HyFiVeUser/HyFiVe/01_Logger/01_Basic_Logger/04_Sensors/sensorIntegration.md

# Functionality of the Sensors
## Pyroscience Pico O2
- this sensor is equiped with a UART interface
- connect it to a UART-USB-Adapter
- you can send and recive informations according to the [Comunication Protocoll](https://www.pyroscience.com/en/products/all-meters/pico-o2-sub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)
- you can use the Pyro DeveloperTool to configurate and calibrate the device, see live values and execute measurements

## Atlas scientifig K0.1 | K1.0 | K10
- this sensor is delivered with the EZO-EC board for communication
- the EZO-EC board is equiped with a UART interface and an I2C interface
  - we are using the UART interface
- connect it to a UART-USB-Adapter
- you can send and recive informations according to [EZO ec datasheet](https://files.atlas-scientific.com/EZO-EC-complete-datasheet.pdf)

**NOTE: The result value may be 0 if the measured value is out of range.**

## BlueRobotics TSYS01
- this sensor is equiped with a I2C bus
- the sensor is the slave, so you need to connected it to an existing I2C Bus
- you can send and recive informations according to the [datasheet](https://www.te.com/commerce/DocumentDelivery/DDEController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)

## Keller Series 20

---

# Interfaces used for communication
## UART
- We are using the PmodUSBUART as Interface
- you can find it on [reichelt](https://www.reichelt.de/de/de/shop/produkt/pmod_usb-uart_usb-zu-uart-schnittstelle-243339)
- the manual is also available as [pdf at reichelt](https://cdn-reichelt.de/documents/datenblatt/B300/DIGILIENT_PMODUSBUART_ENG_TDS.pdf)
- there is no driver necessary when using Win10 or Win11
- after connecting to the PC check for the associated com port at the device monitor
- using a serial terminal (e.g. [Putty](https://putty.org/index.html) to establish a connection
- check the commands at the reference manual of the sensor (see above)
- The Pins of the Interface are the following:

|Pin|Signal|Description|
|---|---|---|
|1|RTS|Ready to Send|
|2|RXD|Receive|
|3|TXD|Transmit|
|4|CTS|Clear to Send|
|5|GND|Ground|
|6|SYS3V3|Power Supply (3.3V)|

## I2C
- We are using the [WCH341A Chip](https://wch-ic.com/products/CH341.html), provided on a [platine by berrybase](https://www.berrybase.de/usb-i2c-iic-spi-uart-ttl-isp-all-in-one-konverter-mit-ch341a-chipsatz)
- this interface has multiple capabilitys (I2C, UART, ...)
- You need to install a driver on windows, provided bei the manufactor [WCH](https://www.wch-ic.com)
  - for UART install the [serial driver](https://www.wch-ic.com/downloads/CH341SER_EXE.html) (the rest works as described above)
  - for I2C install the [parallel driver](https://www.wch-ic.com/downloads/CH341PAR_EXE.html)
- There is a tool (no installation needed) for communication dedicated to this Chipset, called [CH341A_tool](https://github.com/tomek-o/CH341A-tool)
- You can search for connected participans on I2C and read/write on the bus
- check the reference manual of the sensor for commands to be used (see above)
- The Pins are directly named on the board

---

# Commissioning and calibration
## Pyroscience Pico O2
- This sensor needs to be initalized with the values provided by the sensor cap
- We use the Pyro DeveloperTool (provided by PyroScience)
<br><br>
- attach the sensorcap to the pico
- connect the pico with your PC
  - you can use the provided USB-Cable
  - you can also use any other USB-to-UART interface

- start the pyro DeveloperTool
- klick on settings on the top left corner
- enter the code of the sensor-cap label
- select if you want to use fixed enviromental values or measured ones
  - in this project we use fixed values, because this will be set during the sensorhandling process
  - set the ambientpreasure to 1013 mBar
  - set the salinity to 0 PSU
  - set the Temperature to 20 °C
<br><br>**TODO: images**<br><br>
- The sensor is now able to measure and you should get first rough values in the diagram
<br><br>**TODO: images**<br><br>
- there are diferent ways to execute a **Calibration**:
    - Calibrate in ambient air
    - Calibrate in water
      - as a single point calibration
      - as a two point calibration
<br><br>
- As we want to use the sensor in water and both (0% and 100% saturation) are in our interest we recommend to perform a two point calibration in Water
- for 0% oxygen you can use a solution of natriumdisulfit in water
- for 100% oxygen you can use water wich was enriched with air
  - you can use a bubbler
  - you can just it from one tumbler to another with plenty of space between them (so that the air is mixed in)
<br><br>
- The calibration is similar in both points
- put the sensor in the correct fluid
- wait until you get a stable value (check at the live diagram)
<br><br>**TODO: images**<br><br>
- Start the calibration process by clicking on "Calibration"
- choose wich point you want to calibrate
  - 0%
    - set to **TODO: check and doc correct settings**
  - 100%
    - set to **TODO: check and doc correct settings**
- This will take a few seconds
- afterwards the value is adjusted and you should have current values around your calibrationpoint
<br><br>**TODO: images**<br><br>
- after calibration you have to save the values to the flash memory
<br><br>**TODO: images**<br><br>

## Atlas scientifig K0.1 | K1.0 | K10
- the calibration is dependnt of the board and the sensor
  - you need to change the bundle of board and sensor for each calibration, instead of just switch the sensor
- connect the sensor with the corresponding board to the UART interface
- start a serial terminal and connect to the sensor
- you can read the current value with the command "*C,1*" (**C**ontinious read every **1** second)
- if the sensor was already calibrated (response to "*Cal,?*" is "*Cal,1*" or "*Cal,2*"), but has bad values you may like to calibrate it again
  - Therefore you should clear current calibration first with the command "*Cal,clear*"
  - response should be "*\*OK*"
  - Afterwards continue with the normal calibration process
<br><br>**TODO: images**<br><br>
- For calibration use two different calibration liquids
- you need to execute the whole calibration routine at once:
  - start with a dry sensor
  - enable reading, if not already enabled: "*C,1*"
  - wait for a stable value
  - send command "*Cal,dry*"
  - response should be "*\*OK*"
  - insert sensor in the lower calibration liquid
  - wait for a stable value
  - send command "*Cal,low,[value]*", where *[value]* is replaced by the conductivity of your probe in µS/cm
    - keep in mind to enter the correct value depending on the current temperature of your liquid. There should be temperature tables provided by the liquid manufactor, as the conductivity is highly influenced by the temperature
  - response should be "*\*OK*"
  - remove the sensor from the first calibration liquid, clean and dry it
  - insert sensor in the higher calibration liquid
  - wait for a stable value
  - send command "*Cal,high,[value]*", where *[value]* is replaced by the conductivity of your probe in µS/cm
    - keep in mind to enter the correct value depending on the current temperature of your liquid. There should be temperature tables provided by the liquid manufactor, as the conductivity is highly influenced by the temperature
  - response should be "*\*OK*"
  - the calibration is finished now
  - disable reading: "*C,0*"
  - response should be "*\*OK*"
  - you can check the calibration with the command "*Cal,?*", the response should be "*?Cal,2*" and "*\*OK*"

## BlueRobotics TSYS01
- Connect the Sensor to an I2C bus
- the adress should be 0x77
- to read the calibration coefficients you have to send the following commands and read the response (2bytes)
- the response (2bytes) is the result, represented as a hexadezimal value

|target|command|example response|decimal value|
|---|---|---|---|
|Coefficient k0|0xAA|0x8545|34117|
|Coefficient k1|0xA8|0x5865|22629|
|Coefficient k2|0xA6|0x3E7C|15996|
|Coefficient k3|0xA4|0x1CAA|7338|
|Coefficient k4|0xA2|0x1652|5714|

<br><br>**TODO: images**<br><br>

- for the hyfive-logger this values musst be transfered to the calibration settings of the sensor

## Keller Series 20
