HyFiVeUser/HyFiVe/01_Logger/02_Modular_Logger/02_Mechanics/01_electronic_mounting/logger_mounting_battery_base_V02.png

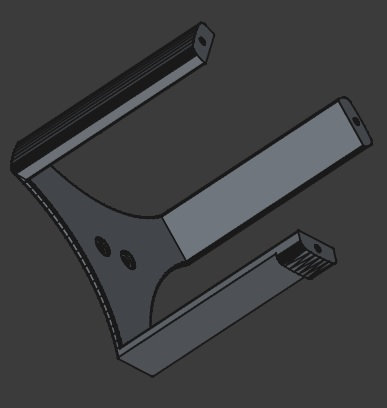
01_Logger/02_Modular_Logger/02_Mechanics/01_electronic_mounting/logger_mounting_battery_base_V02.png
