HyFiVeUser/HyFiVe/01_Logger/02_Modular_Logger/02_Mechanics/01_pressure_housing/02_cylinder/Logger_cylinder.png

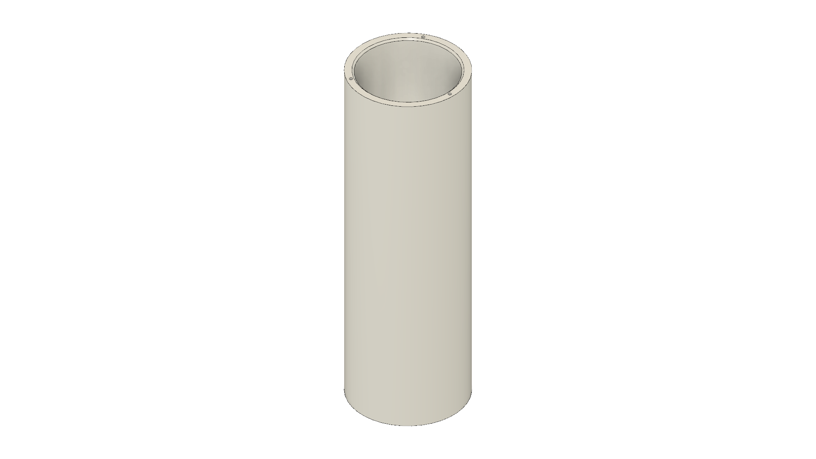
01_Logger/02_Modular_Logger/02_Mechanics/01_pressure_housing/02_cylinder/Logger_cylinder.png
