HyFiVeUser/HyFiVe/01_Logger/02_Modular_Logger/02_Mechanics/01_pressure_housing/03_endcaps/End_cap_drilling_charging.png

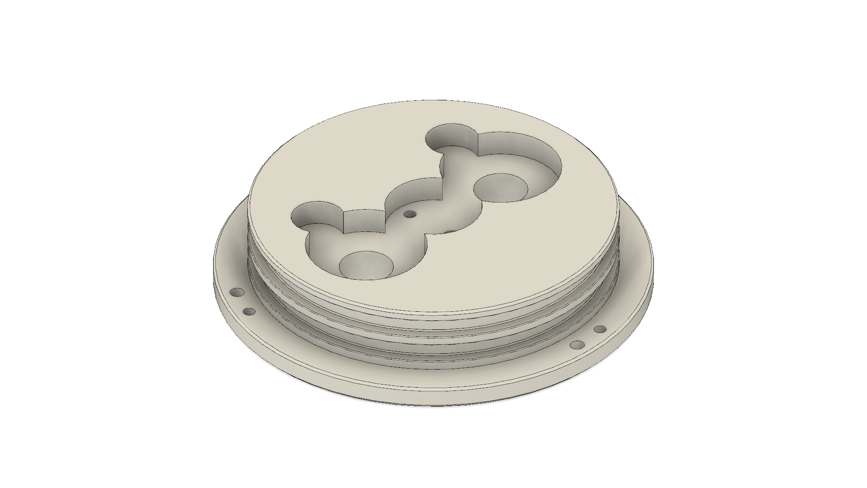
01_Logger/02_Modular_Logger/02_Mechanics/01_pressure_housing/03_endcaps/End_cap_drilling_charging.png
