HyFiVeUser/HyFiVe/01_Logger/02_Modular_Logger/02_Mechanics/01_pressure_housing/04_penetrators/penetrator_charging_V02.png

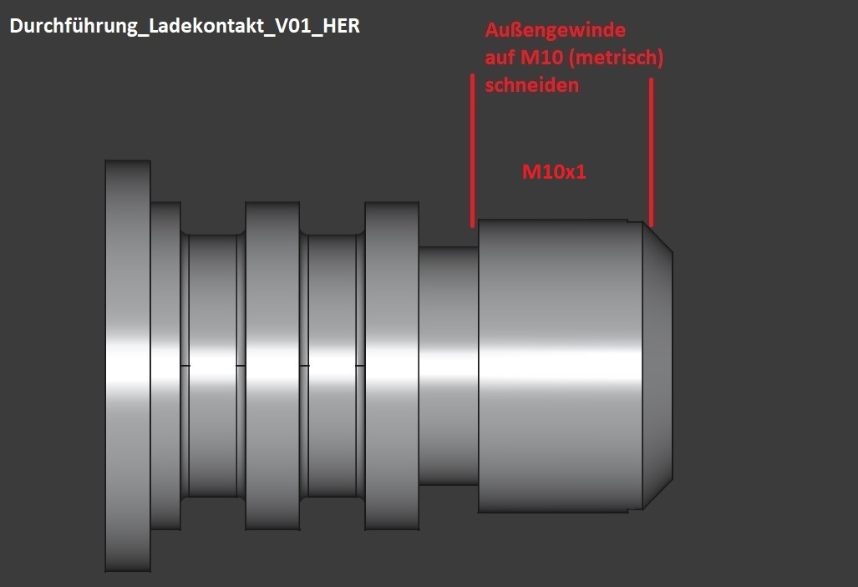
01_Logger/02_Modular_Logger/02_Mechanics/01_pressure_housing/04_penetrators/penetrator_charging_V02.png
