HyFiVeUser/HyFiVe/01_Logger/02_Modular_Logger/02_Mechanics/01_pressure_housing/04_penetrators/penetrator_sensor_Atlas_K1_0.png

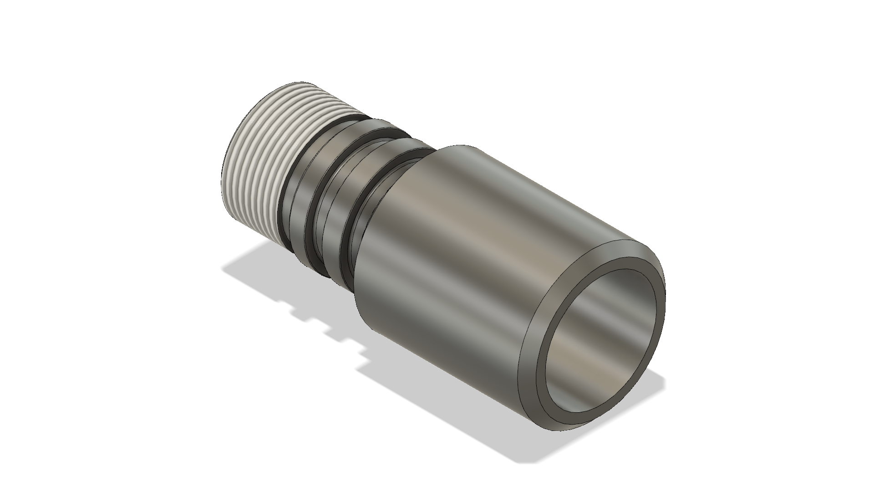
01_Logger/02_Modular_Logger/02_Mechanics/01_pressure_housing/04_penetrators/penetrator_sensor_Atlas_K1_0.png
