HyFiVeUser/HyFiVe/01_Logger/02_Modular_Logger/02_Mechanics/02_Handle_Rope/Cage_ring_metal v4.png

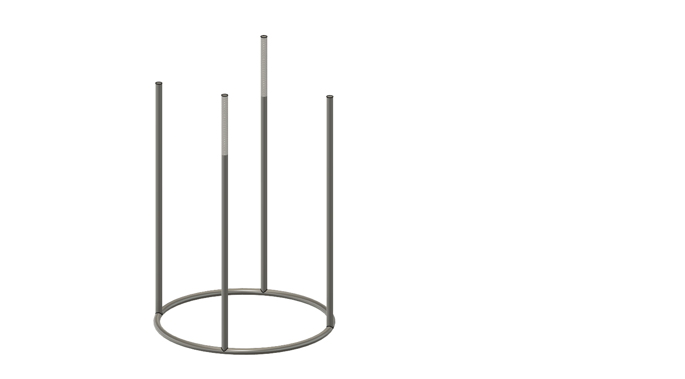
01_Logger/02_Modular_Logger/02_Mechanics/02_Handle_Rope/Cage_ring_metal v4.png
