HyFiVeUser/HyFiVe/02_Deckbox/02_Software/NodeRED/NodeRED_flow_02_MainFlows.PNG

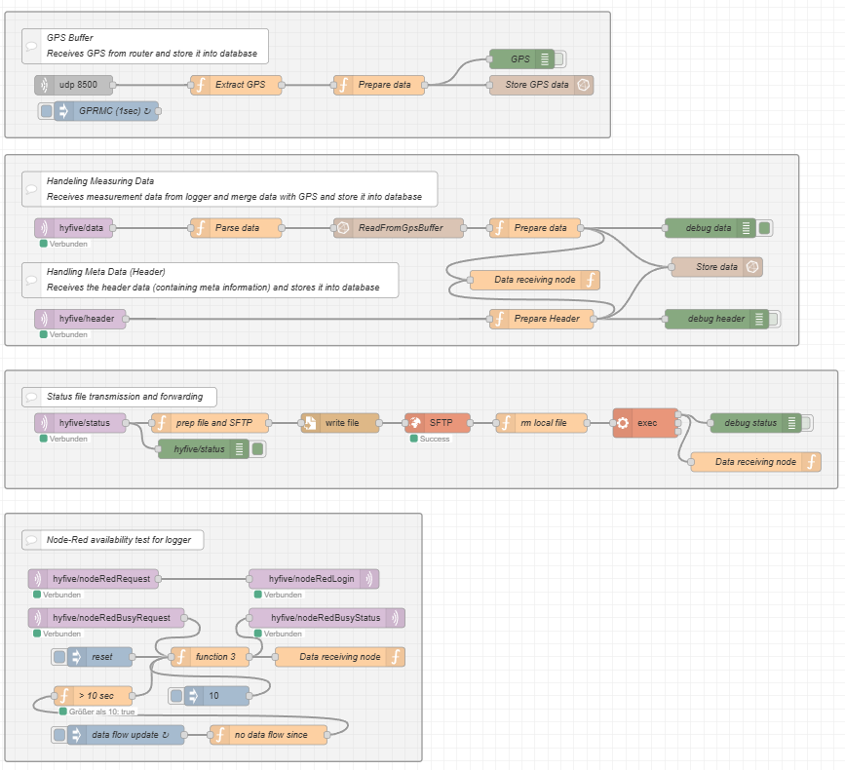
02_Deckbox/02_Software/NodeRED/NodeRED_flow_02_MainFlows.PNG
