HyFiVeUser/HyFiVe/02_Deckbox/02_Software/NodeRED/NodeRED_flow_03_netcdf.PNG

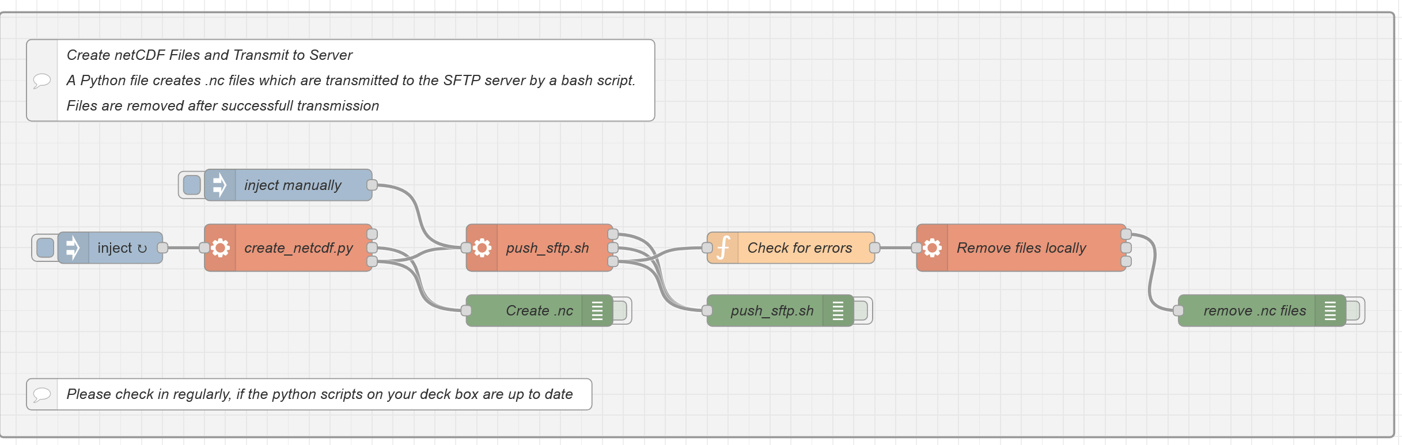
02_Deckbox/02_Software/NodeRED/NodeRED_flow_03_netcdf.PNG
