HyFiVeUser/HyFiVe/02_Deckbox/02_Software/NodeRED/NodeRED_flow_04_Logger log data.PNG

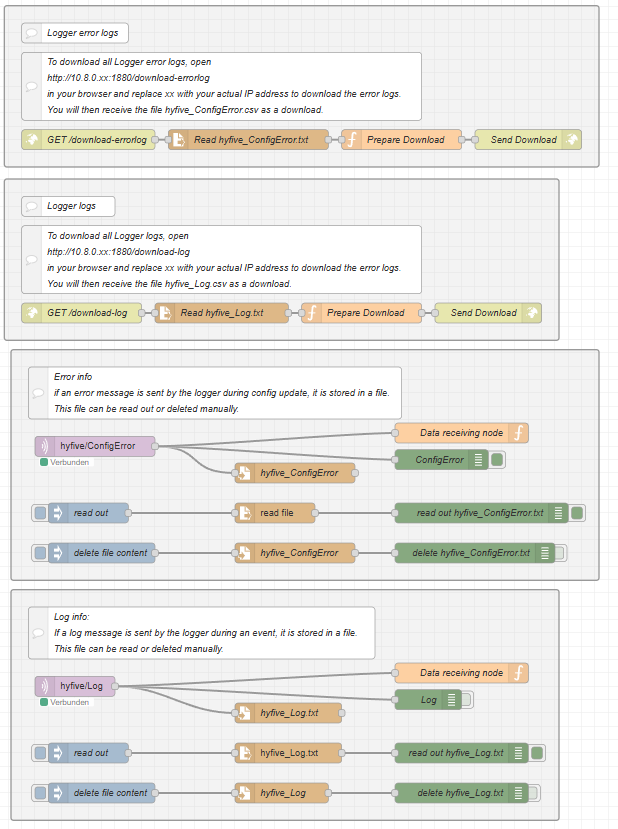
02_Deckbox/02_Software/NodeRED/NodeRED_flow_04_Logger log data.PNG
