HyFiVeUser/HyFiVe/02_Deckbox/02_Software/NodeRED/NodeRED_flow_05_updateConfig.PNG

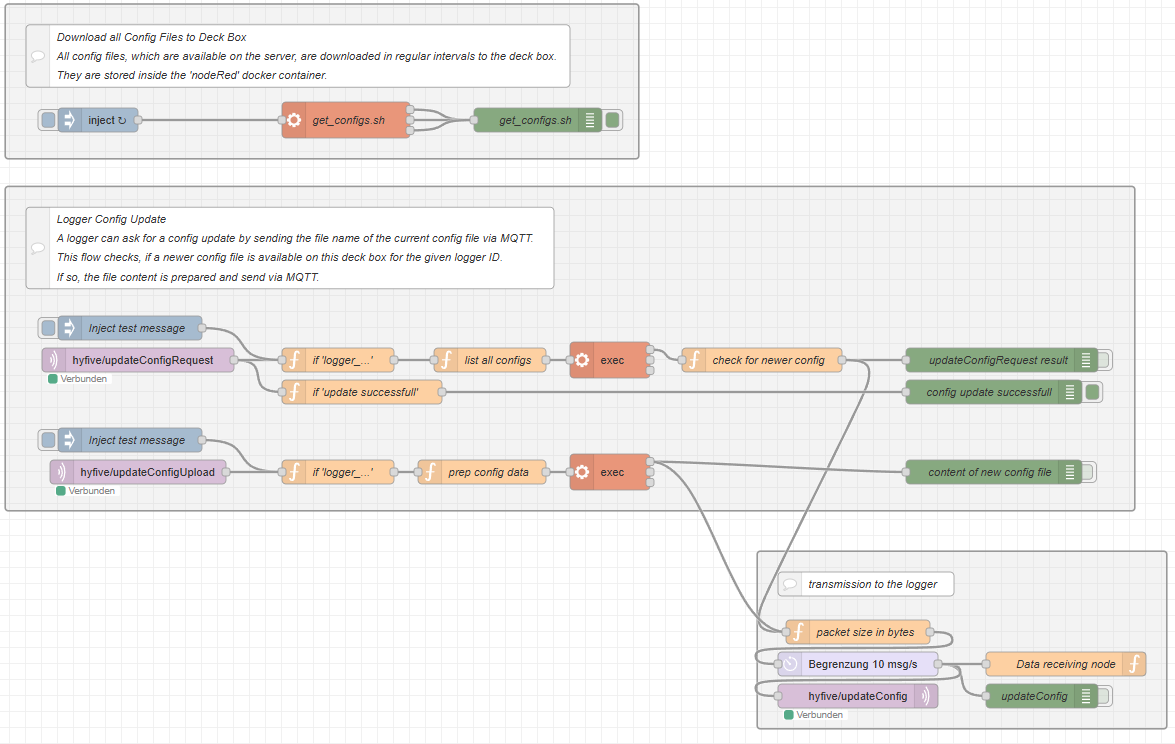
02_Deckbox/02_Software/NodeRED/NodeRED_flow_05_updateConfig.PNG
