HyFiVeUser/HyFiVe/02_Deckbox/02_Software/NodeRED/NodeRED_flow_06_firmware update OTA.png

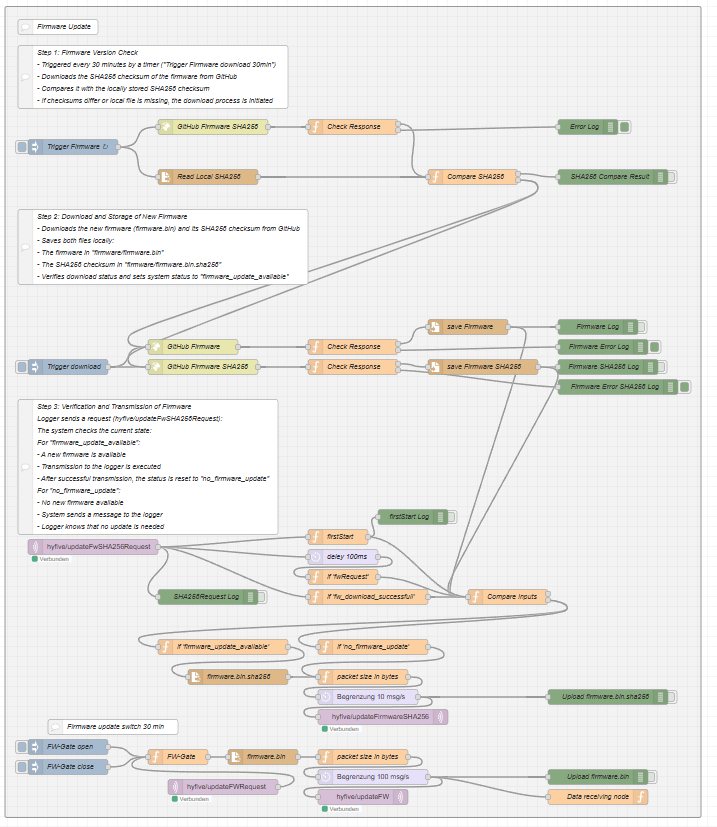
02_Deckbox/02_Software/NodeRED/NodeRED_flow_06_firmware update OTA.png
