HyFiVeUser/HyFiVe/01_Logger/01_Basic_Logger/02_Mechanics/BOM.xlsx

# | Amount | Name
 |  | Pressure cylinder
1 | 1 | Cylinder, POM, D 76/90, L 275, according to drawing
2 | 1 | End cap for sensors, according to drawing
3 | 1 | End cap, blank
4 | 6 | Screws M3 x 14, hexagonal, stainless A4
5 | 4 | O-ring 70 x 3, NBR70
6 | 1 | O-ring lube, e.g. Molycote 44 Medium
 |  | Internal mounting
7 | 1 | Mounting for electronic components, 3D printed
8 | 1 | Mounting for battery pack, 3D printed
9 | 3 | Tapping screw, M2.9 x 9.5, for attaching main PCB
10 | 1 | Screws M6 x 14, hexagonal
 |  | Sensors and accessories
11 | 1 | Temperature: BlueRobotics Celsius Fast Responde, incl. O-ring and nut
12 | 1 | Pressure: Keller 20D, 50bar, incl. adapter PCB
13 | 1 | Oxygen: Pyroscience picoO2sub incl. Oxycap-sub, O-ring and nut
14 | 1 | Conductivity: Atlas Scientific K1.0 incl. adapter board
15 | 1 | Bushing for conductivity sensor, incl. distance sleeve for potting
16 | 1 | Nut M18x1 ('Sechskant-Gegenmutter') GM 181 Schlüsselweite <= 22mm
17 | 2 | O-ring, 15.5 x 2, NBR70
18 | 1 | Pressure valve, BlueRobotics PRV-R1, incl. O-rings and nut
19 | 1 | Vacuum pump, BlueRobotics Vacuum-Pump-R1, incl. adapter for PRV
