HyFiVeUser/HyFiVe/01_Logger/02_Modular_Logger/02_Mechanics/01_electronic_mounting/logger_mounting_battery_base_V02.step

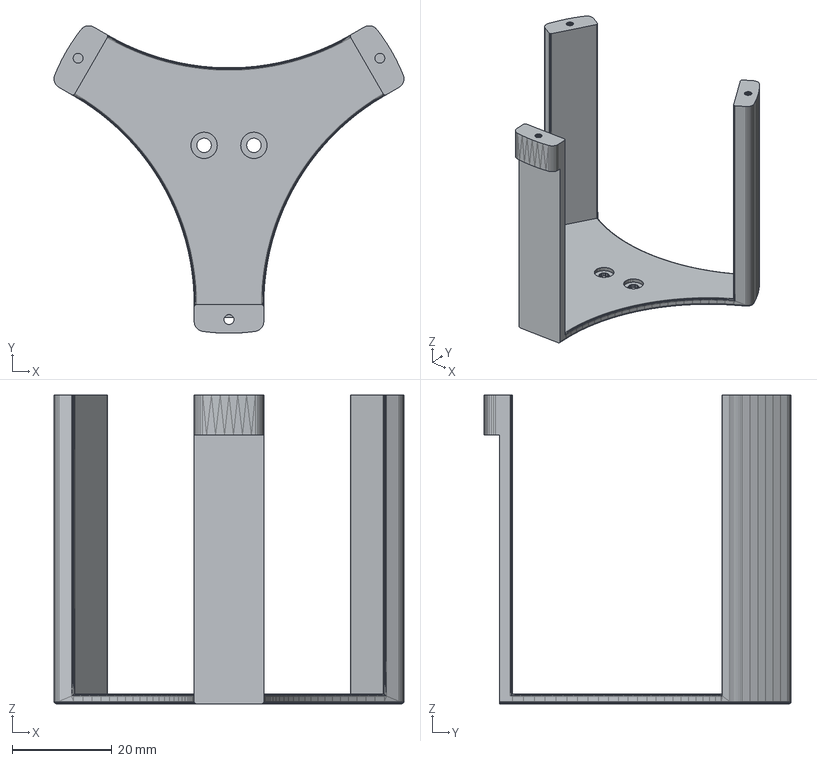
[picture p15: CAD file, 2025-11-10]
01_Logger/02_Modular_Logger/02_Mechanics/01_electronic_mounting/logger_mounting_battery_base_V02.step
70.3 x 61.8 x 62.0 mm
