HyFiVeUser/HyFiVe/01_Logger/02_Modular_Logger/02_Mechanics/01_pressure_housing/02_cylinder/Logger_cylinder.step

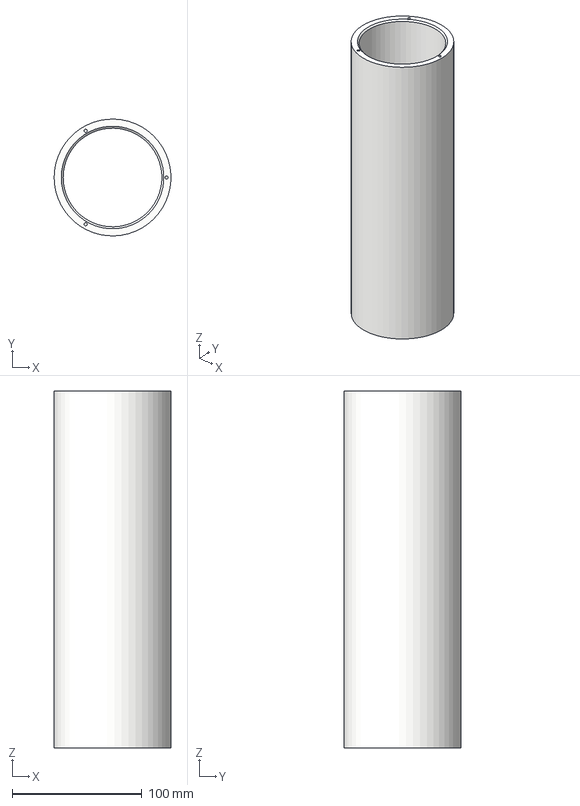
[picture p16: CAD file, 2025-11-10]
01_Logger/02_Modular_Logger/02_Mechanics/01_pressure_housing/02_cylinder/Logger_cylinder.step
89.9 x 90.0 x 275.0 mm
