HyFiVeUser/HyFiVe/01_Logger/02_Modular_Logger/02_Mechanics/01_pressure_housing/03_endcaps/end_cap_drillings_sensors_P6_V01.step

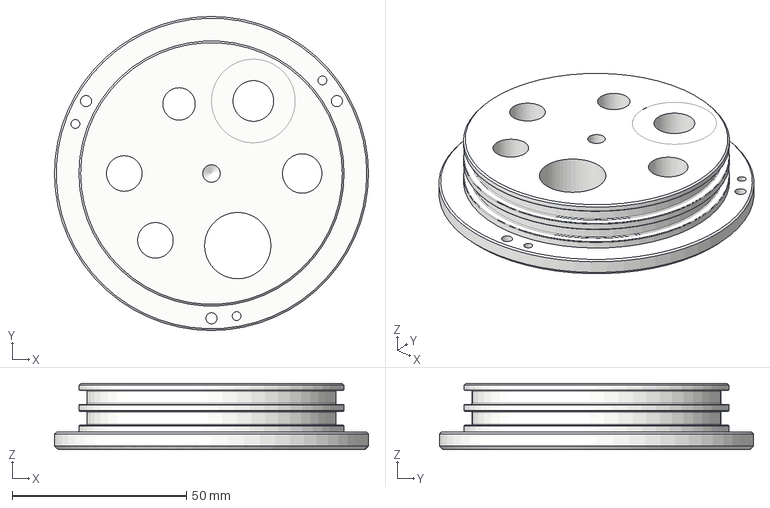
[picture p17: CAD file, 2025-11-10]
01_Logger/02_Modular_Logger/02_Mechanics/01_pressure_housing/03_endcaps/end_cap_drillings_sensors_P6_V01.step
90.0 x 90.0 x 19.0 mm
