HyFiVeUser/HyFiVe/01_Logger/02_Modular_Logger/02_Mechanics/01_pressure_housing/04_penetrators/penetrator_charging_V02.step

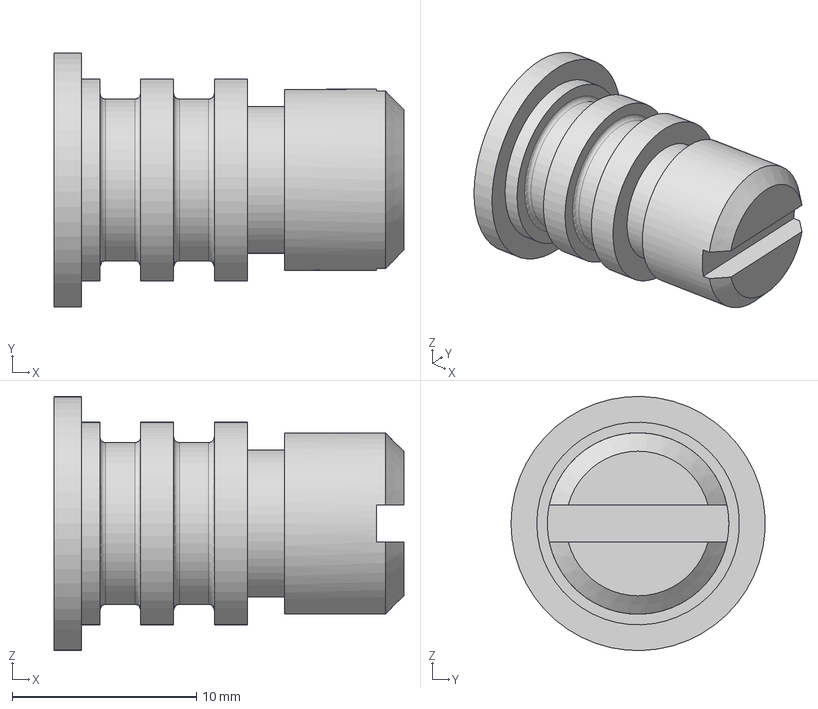
[picture p18: CAD file, 2025-11-10]
01_Logger/02_Modular_Logger/02_Mechanics/01_pressure_housing/04_penetrators/penetrator_charging_V02.step
19.0 x 13.8 x 13.8 mm
