HyFiVeUser/HyFiVe/01_Logger/02_Modular_Logger/02_Mechanics/02_Handle_Rope/3d_Print_Fixation_Ring_M5_realDim.step

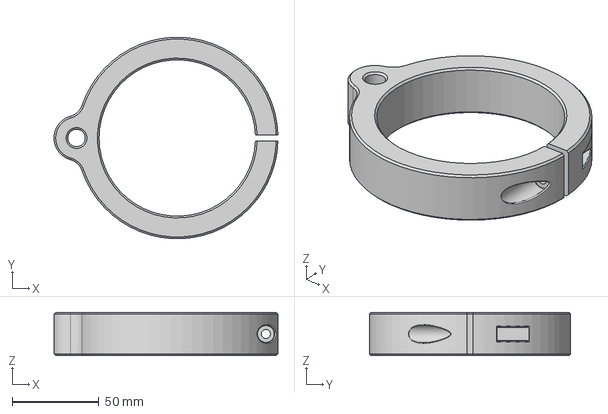
[picture p19: CAD file, 2026-03-27]
01_Logger/02_Modular_Logger/02_Mechanics/02_Handle_Rope/3d_Print_Fixation_Ring_M5_realDim.step
129.0 x 115.9 x 25.0 mm
