HyFiVeUser/HyFiVe/01_Logger/02_Modular_Logger/02_Mechanics/01_pressure_housing/04_penetrators/penetrator_sensor_Atlas_K1_0.step

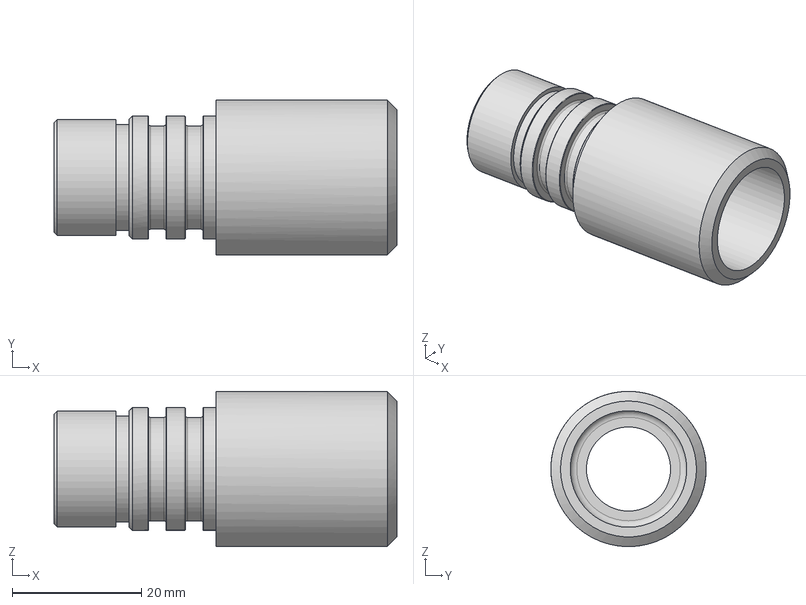
[picture p20: CAD file, 2025-11-10]
01_Logger/02_Modular_Logger/02_Mechanics/01_pressure_housing/04_penetrators/penetrator_sensor_Atlas_K1_0.step
53.0 x 24.0 x 24.0 mm
