HyFiVeUser/HyFiVe/01_Logger/02_Modular_Logger/02_Mechanics/01_pressure_housing/03_endcaps/End_cap_drilling_charging.step

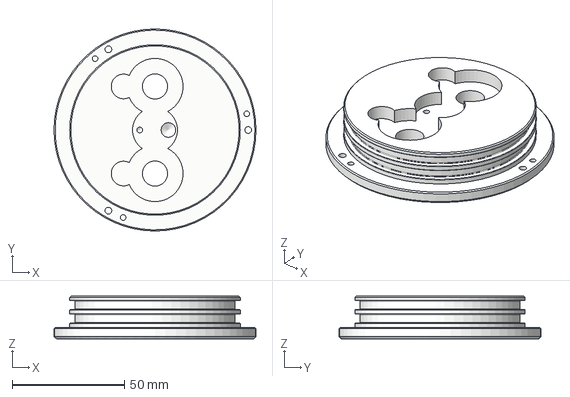
[picture p22: CAD file, 2025-11-10]
01_Logger/02_Modular_Logger/02_Mechanics/01_pressure_housing/03_endcaps/End_cap_drilling_charging.step
90.0 x 90.0 x 19.0 mm
