HyFiVeUser/HyFiVe/01_Logger/02_Modular_Logger/02_Mechanics/02_Handle_Rope/Cage_ring_metal.step

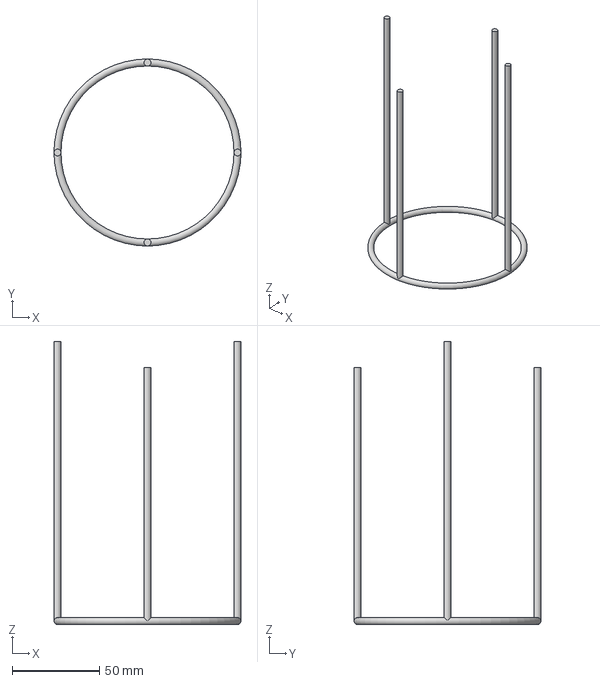
[picture p23: CAD file, 2026-03-27]
01_Logger/02_Modular_Logger/02_Mechanics/02_Handle_Rope/Cage_ring_metal.step
107.0 x 107.0 x 162.0 mm
