HyFiVeUser/HyFiVe/(list of files, cad)

Other CAD files:
01_Logger/02_Modular_Logger/02_Mechanics/01_pressure_housing/03_endcaps/end_cap_drillings_sensors_P5_V01.step
01_Logger/02_Modular_Logger/02_Mechanics/01_pressure_housing/02_cylinder/Logger_cylinder.f3d
01_Logger/02_Modular_Logger/02_Mechanics/01_pressure_housing/03_endcaps/End_cap_drilling_charging.f3d
01_Logger/02_Modular_Logger/02_Mechanics/01_pressure_housing/03_endcaps/end_cap_drillings_sensors.f3d
01_Logger/02_Modular_Logger/02_Mechanics/01_pressure_housing/04_penetrators/penetrator_sensor_Atlas_K1_0.f3d
01_Logger/02_Modular_Logger/02_Mechanics/02_Handle_Rope/3d_Print_Cage_Ring_M5_realDim.f3d
01_Logger/02_Modular_Logger/02_Mechanics/02_Handle_Rope/3d_Print_Fixation_Ring_M5_realDim.f3d
01_Logger/02_Modular_Logger/02_Mechanics/02_Handle_Rope/Cage_ring_metal.f3d
01_Logger/02_Modular_Logger/02_Mechanics/02_Handle_Rope/Handle_Rope_Assembly.f3z
