HyFiVeUser/HyFiVe/01_Logger/02_Modular_Logger/02_Mechanics/02_Handle_Rope/3d_Print_Cage_Ring_M5_realDim v3.png

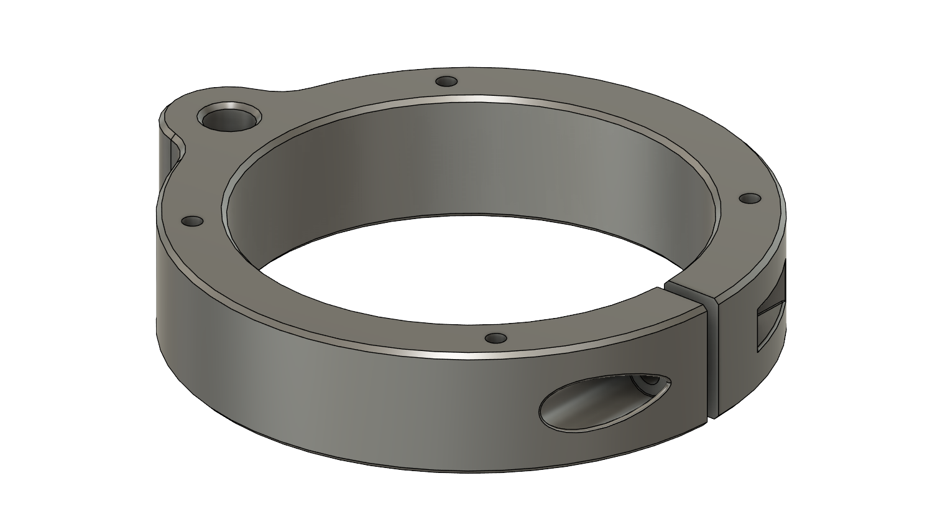
01_Logger/02_Modular_Logger/02_Mechanics/02_Handle_Rope/3d_Print_Cage_Ring_M5_realDim v3.png
