HyFiVeUser/HyFiVe/01_Logger/02_Modular_Logger/02_Mechanics/02_Handle_Rope/3d_Print_Fixation_Ring_M5_realDim v2.png

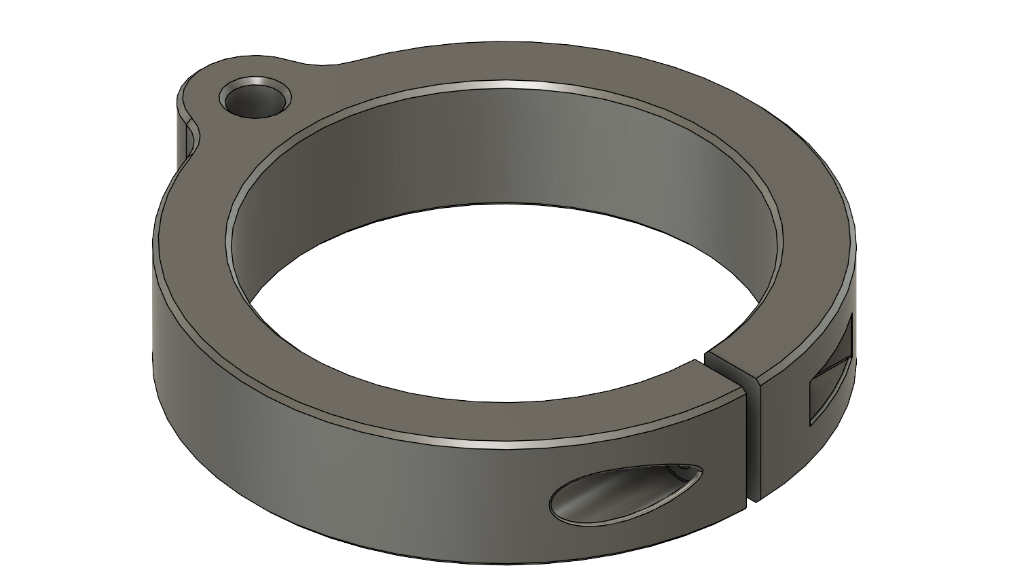
01_Logger/02_Modular_Logger/02_Mechanics/02_Handle_Rope/3d_Print_Fixation_Ring_M5_realDim v2.png
