HyFiVeUser/HyFiVe/02_Deckbox/02_Software/NodeRED/NodeRED_flow_07_TestFunctionality - Kopie.PNG

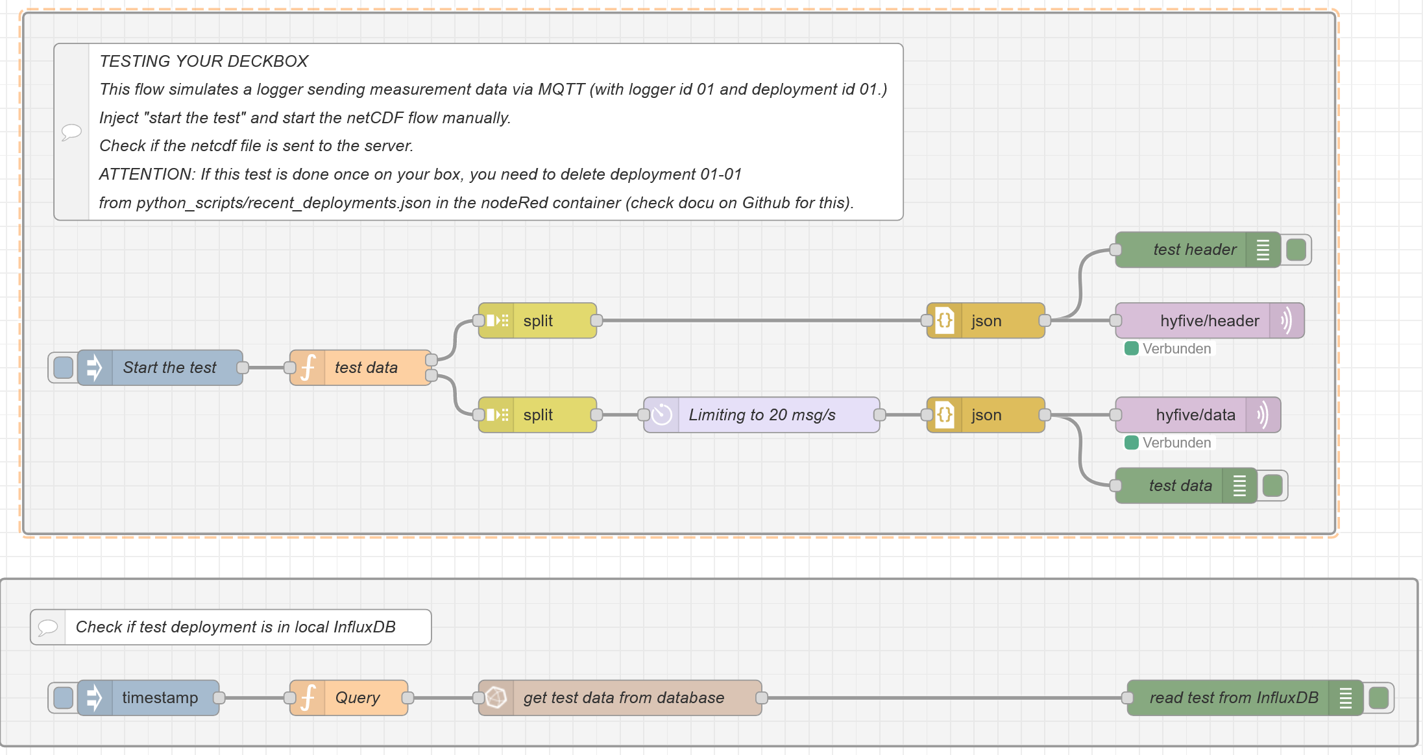
02_Deckbox/02_Software/NodeRED/NodeRED_flow_07_TestFunctionality - Kopie.PNG
