HyFiVeUser/HyFiVe/02_Deckbox/02_Software/NodeRED/NodeRED_flow_01_ChangeLog.PNG

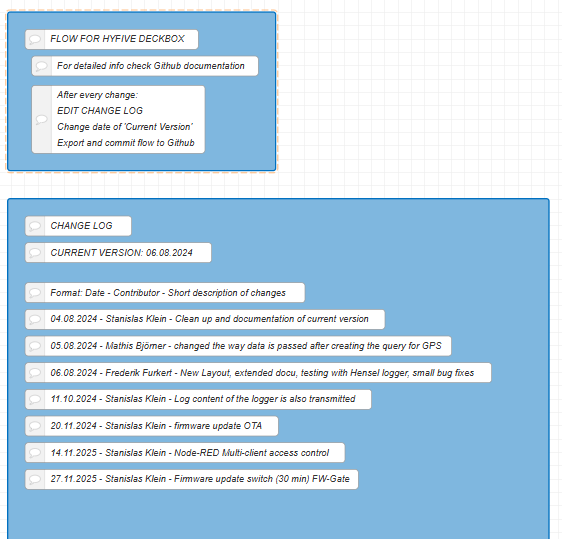
02_Deckbox/02_Software/NodeRED/NodeRED_flow_01_ChangeLog.PNG
