HyFiVeUser/HyFiVe/(threads)

Thread 4 (2025-09-16):

Logger stops charging before full charge

sw-of, 2025-09-16:
# Problem Description:
## Short Version:
The logger stops charging after increasing the SOC by 60-65%.

## Long Version:
When starting charging between a remaining SOC of 0% to 39%, the logger will stop charging before it reaches a full charge. In this case, the LED still blinks as if the logger is charging, but the SOC does not increase (checked in the status files). This will not change even if the logger remains plugged in for several hours.
To fully charge the logger, the charger must be unplugged and plugged in again. There is no waiting time required between unplugging and plugging in the logger.

## Workaround:
Restart charging (unplug and plug in the charger)

## Proposed Solution:
TBD - seems to be a BMS issue

Thread 5 (2025-09-17):

Unit of oxygen saturation should be ml/l in export data

sw-of, 2025-09-17:
# Problem description:
## short version:
In the data export as unit for the oxygen saturation should ml/l be used.

## long version:
the oxygen saturation is usually used to be ml/l instead of mbar (partial pressure). This could be also additional to the current values.

## workaround:
convert the values at your own ;)

## Proposed solution:
add a conversion to the sql-script or create a automatism in a excel sheet

Thread 6 (2025-09-17):

Structure of config-json is not good for human reading

sw-of, 2025-09-17:
# Problem description:
## Short version:
The sensor type is located near the end of the sensor field when reading the config JSON.

## Long version:
The config file contains several other values, including calibration factors, making it difficult to identify all installed sensor types. It would be easier to read if the sensor type were the first value within the sensor structure in the JSON file.

## Workaround:
None

## Proposed solution:
Reorganize the creation of the config JSON file to prioritize the sensor type.

Thread 8 (2025-09-17):

Broken battery holder/battery holder to small

sw-of, 2025-09-17:
# Problem description:
## Short version:
The battery holder is too short for the used battery pack.

## Long version:
In the following picture, you can see that there is a gap between the body and the lid of the battery holder. Additionally, the lid is slightly deformed. As a result, the lid has broken several times.
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

## Workaround:
Do not tighten the screw too much. Using a longer screw could be a additional improvment.

## Proposed solution:
Redesign the lid. The plate should be slightly thicker as well. Change the thickness of the plate to 2 mm and the length of the rod to 8 mm.

Thread 9 (2025-09-19):

Integration into O2A

Maysen42, 2025-09-19:
# Integration into O2A
O2A is a datapipeline framework developed by the Alfred Wegner Institute in Bremerhaven (AWI).
This framework would possibly allow a near realtime data distribution for HyFiVe plus automatic analysis of data, including malfunctioning sensor detection and overview over devices in use.

This might also be an option for a new visualisation interface, but that needs to be further investigated

Thread 12 (2025-10-01):

create_netcdf.py-script doesn't handle deployments as list instead of dataframe

Maysen42, 2025-10-01:
# Problem description:
## Short version:
In some cases create_netcdf.py needs to handle a list of dataframes instead of just a dataframe. Currently this isn't done right.

## Long version:
If the configurations of deployments, which shall be read from the influxDB, vary for example because there is a new sensor or one less then before, influx will hand this data as a list of dataframes, rather then just sending it in one dataframe, as would be the normal case.

## Workaround:
A current workaround could be to minimize the period in which to look for data in influxDB. As long as all the data from this period is homogenous, then the script will work fine.

## Proposed solution:
There should be an adaption in the main function where the influx-client calls for the data to check if the returned data is a list and should then be handled apropriately, one after the other.
The Parameters-part of the script should also be able to handle different parameter configurations which exist as lists.

Maysen42, 2025-10-01:
pushed some changes to the according branch. Commit needs to be tested and approved.
