HyFiVeUser/HyFiVe/01_Logger/02_Modular_Logger/02_Mechanics/01_pressure_housing/03_endcaps/production_drawing_end_caps_blank.pdf

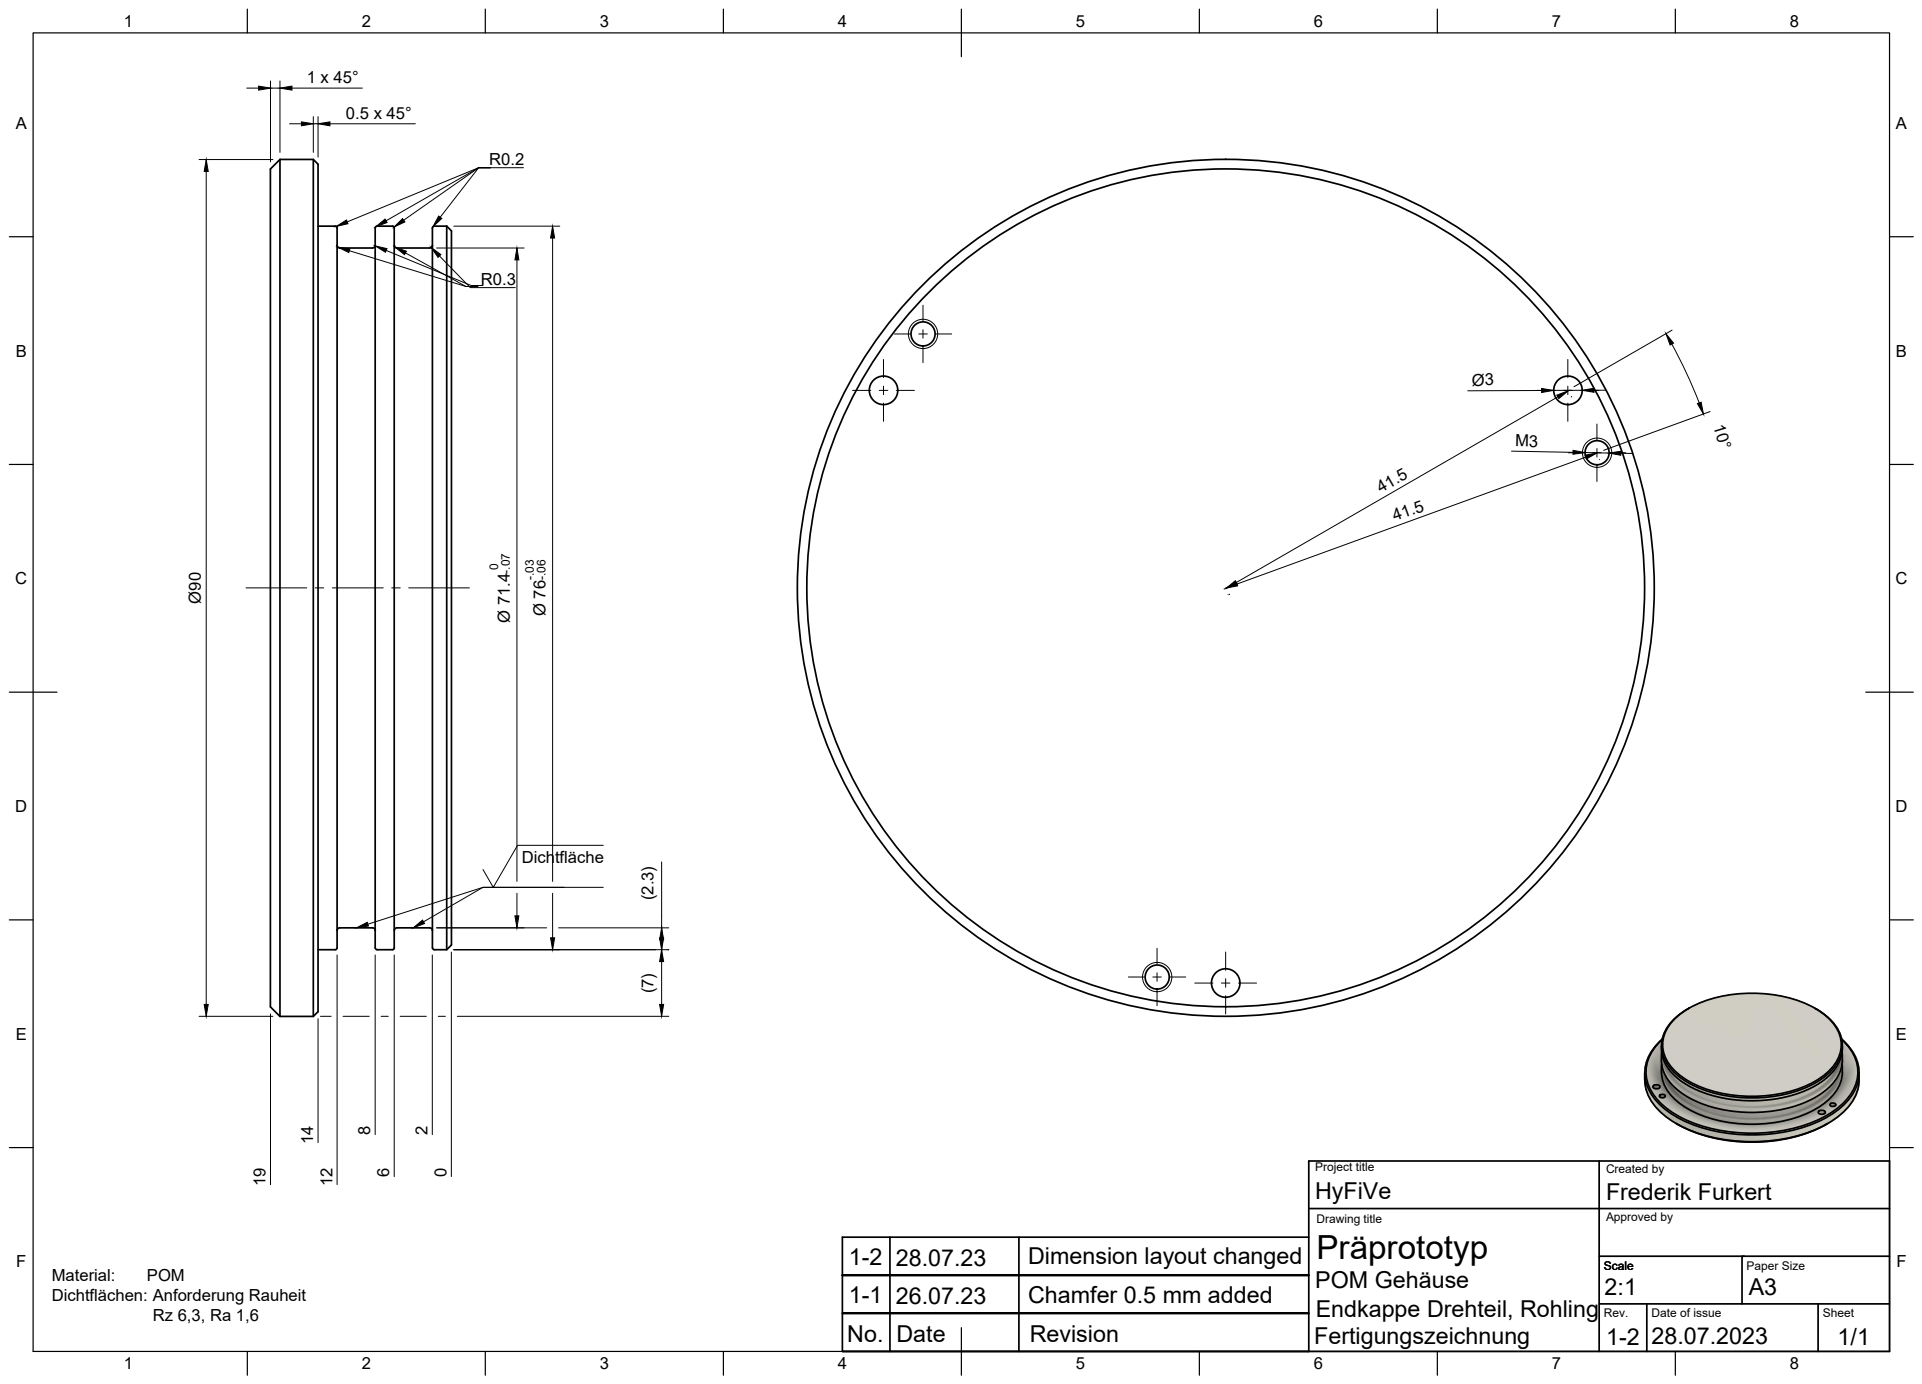
[picture p28: page 1]
Rev.; Date of issue; Sheet

Project title HyFiVe | Created by Frederik Furkert

Drawing title
Präprototyp
POM Gehäuse
Endkappe Drehteil, Rohling
Fertigungszeichnung

Approved by

1-2 | 28.07.23 | Dimension layout changed
1-1 | 26.07.23 | Chamfer 0.5 mm added

Dichtflächen: Anforderung Rauheit

Scale 2:1 | Paper Size A3
