HyFiVeUser/HyFiVe/01_Logger/02_Modular_Logger/02_Mechanics/01_pressure_housing/02_cylinder/production_drawing_cylinder.pdf

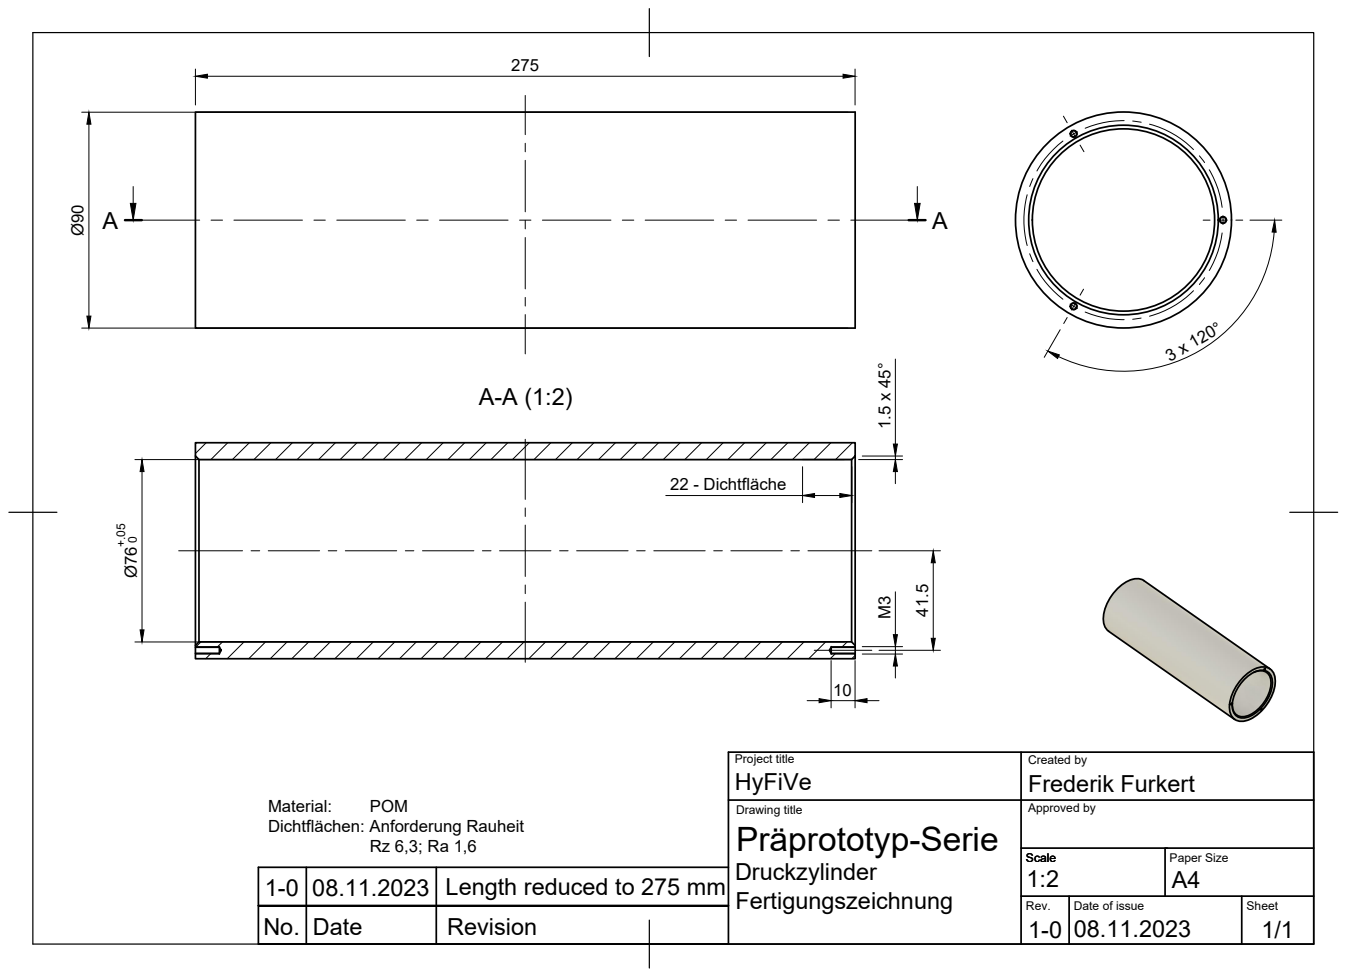
[picture p29: page 1]
Length reduced to 275 mm; 22 - Dichtfläche

Project title HyFiVe | Created by Frederik Furkert

Dichtflächen: Anforderung Rauheit

Drawing title Präprototyp-Serie Druckzylinder Fertigungszeichnung | Approved by

Scale | Paper Size

Rev. | Date of issue | Sheet 1/1
