HyFiVeUser/HyFiVe/01_Logger/02_Modular_Logger/02_Mechanics/01_pressure_housing/03_endcaps/production_drawing_end_caps_drillings_charging.pdf

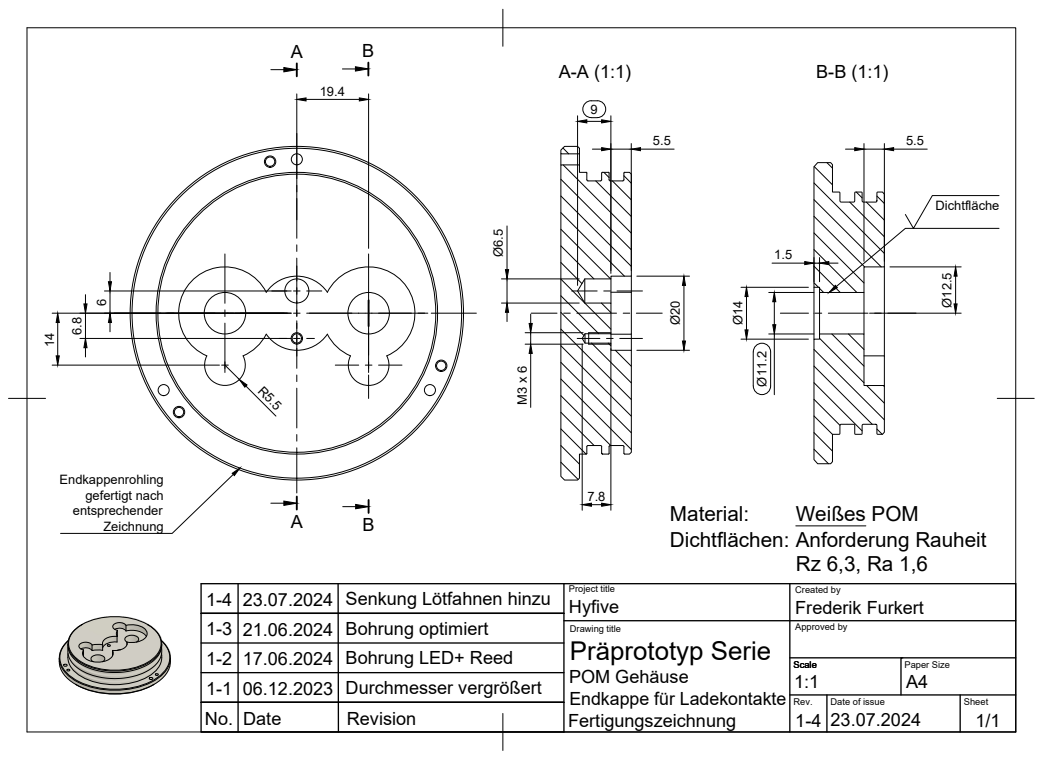
[picture p30: page 1]
gefertigt nach; Zeichnung; Material:; Weißes POM

Dichtflächen: Anforderung Rauheit

1-4 | 23.07.2024 | Senkung Lötfahnen hinzu | Project title Hyfive | Created by Frederik Furkert

1-3 | 21.06.2024 | Bohrung optimiert
1-2 | 17.06.2024 | Bohrung LED+ Reed
1-1 | 06.12.2023 | Durchmesser vergrößert

Drawing title Präprototyp Serie POM Gehäuse Endkappe für Ladekontakte Fertigungszeichnung | Approved by

Scale 1:1 | Paper Size A4

Rev. | Date of issue | Sheet 1/1
