HyFiVeUser/HyFiVe/01_Logger/02_Modular_Logger/02_Mechanics/01_pressure_housing/04_penetrators/production_drawing_penetrator_sensor_AtlasK1-0.pdf

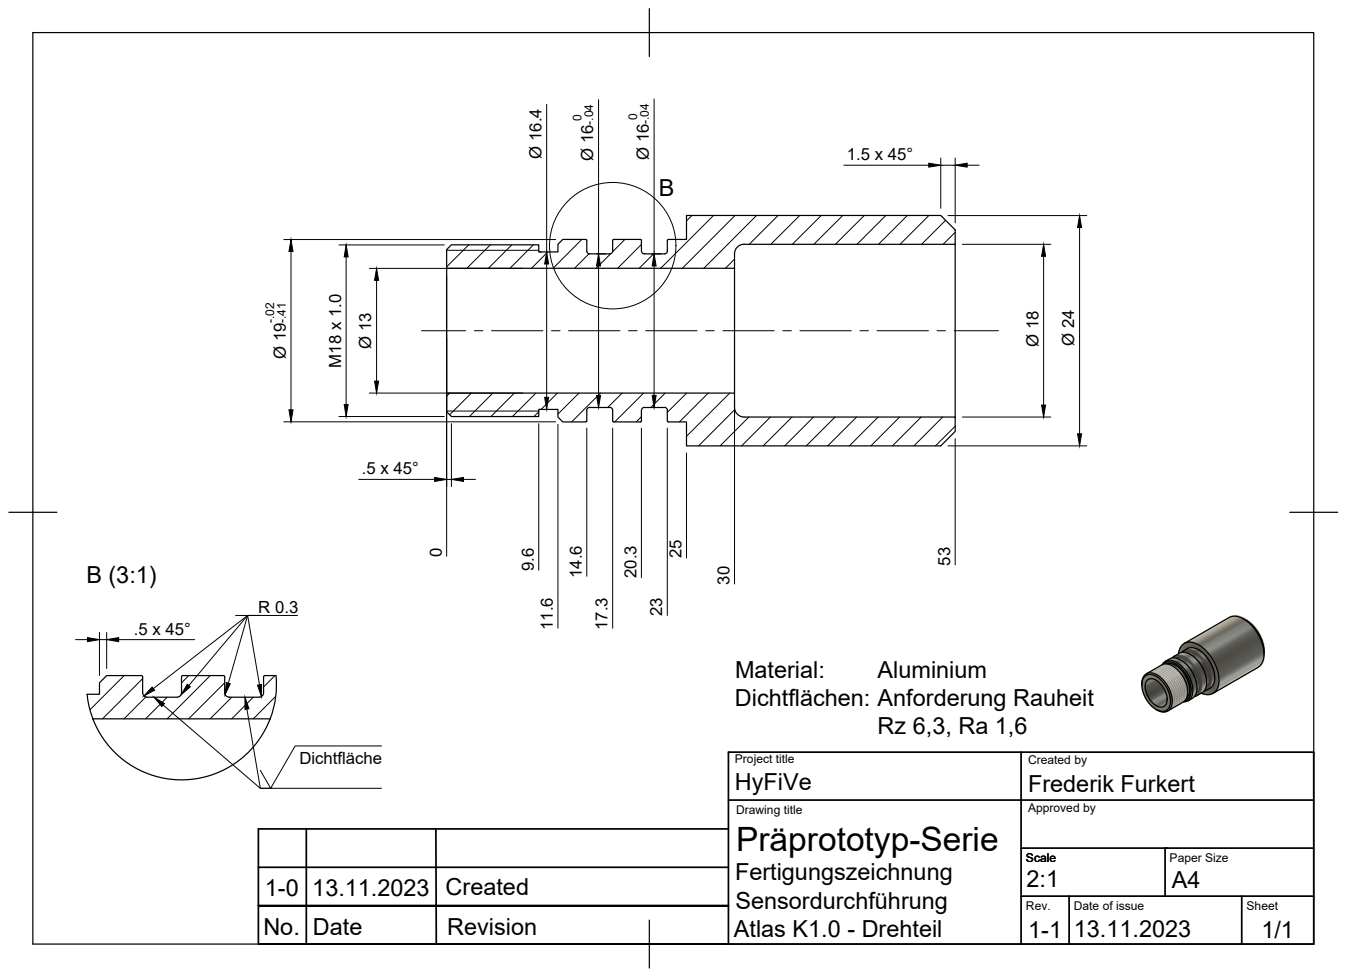
[picture p31: page 1]
Created

Dichtflächen: Anforderung Rauheit

Project title HyFiVe | Created by Frederik Furkert

Drawing title Präprototyp-Serie Fertigungszeichnung Sensordurchführung Atlas K1.0 - Drehteil | Approved by

Scale 2:1 | Paper Size A4

Rev. | Date of issue | Sheet 1/1
