HyFiVeUser/HyFiVe/01_Logger/02_Modular_Logger/01_Electronics/01_Main_Unit/01_main_unit_MCU/main_unit.kicad_pcb

## KiCad design 01_Logger/02_Modular_Logger/01_Electronics/01_Main_Unit/01_main_unit_MCU/main_unit.kicad_pcb (2025-11-10)

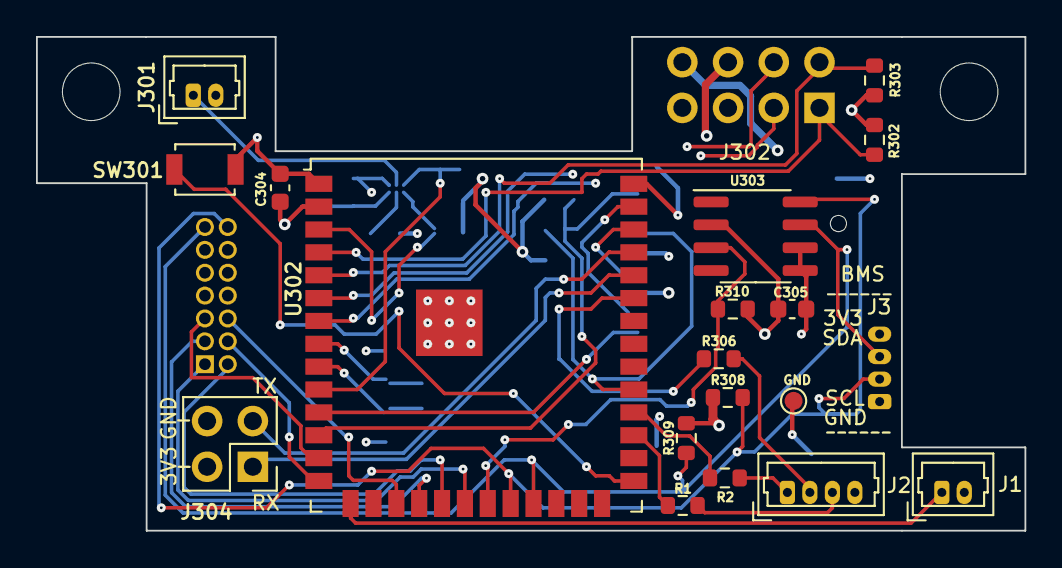
[picture p32: board 01_Logger/02_Modular_Logger/01_Electronics/01_Main_Unit/01_main_unit_… from above]

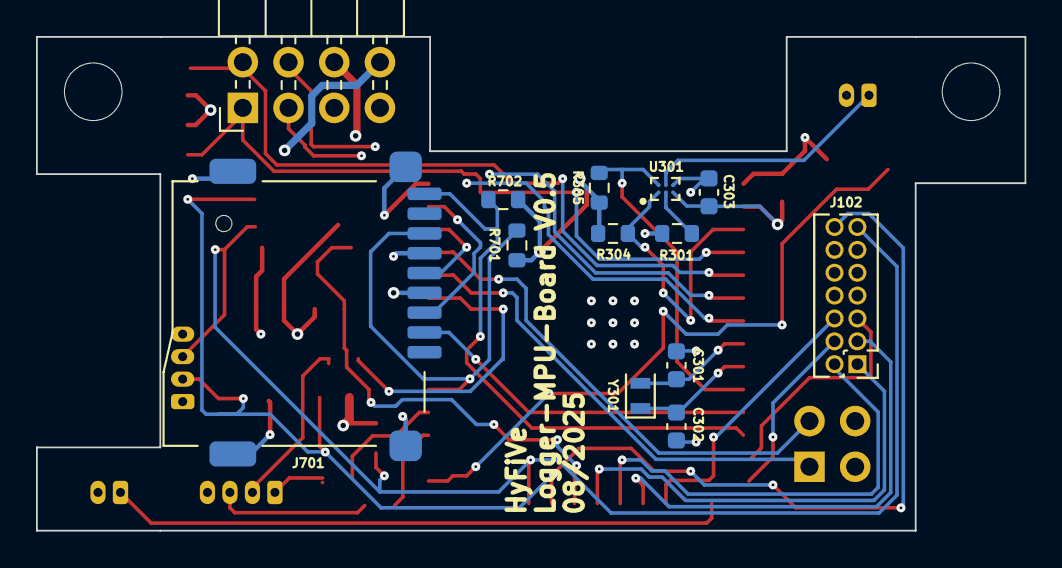
[picture p33: board 01_Logger/02_Modular_Logger/01_Electronics/01_Main_Unit/01_main_unit_… from below]

Board: 4 copper layers, 54.9 x 27.4 mm, 34 parts (13 on the bottom side), 35 nets.

Parts:
C301, C302: 20pF; C_0603_1608Metric
C303, C304, C305: 100nF 50V; C_0603_1608Metric
H303, H305: MountingHole; MountingHole_3.2mm_M3_ISO7380
J1, J301: Conn_01x02; Molex_PicoBlade_53047-0210_1x02_P1.25mm_Vertical
J2, J3: Conn_01x04_Pin; Molex_PicoBlade_53047-0410_1x04_P1.25mm_Vertical
J102: FTS-107-01-F-D; PinHeader_2x07_P1.27mm_Vertical
J302: Conn_02x04_Counter_Clockwise; PinHeader_2x04_P2.54mm_Horizontal
J304: Conn_02x02_Odd_Even; PinHeader_2x02_P2.54mm_Vertical
J701: Micro_SD_Card_Det; SD_CARD_693071020811
R1, R2: 0R; R_0603_1608Metric
R301: 470k; R_0603_1608Metric
R302, R303, R304, R305, R308, R309, R310, R701, R702: 10k; R_0603_1608Metric
R306: 68R; R_0603_1608Metric
SW301: SW_Push; SW_SPST_B3U-1000P
TP303: TestPoint; TestPoint_Pad_D1.0mm
U301: MAX16125WTEG00+T; WLP-6
U302: ESP32-S3-WROOM-1U
U303: DS3231MZ; SOIC-8_3.9x4.9mm_P1.27mm
Y301: Crystal; Crystal_SMD_TXC_9HT11-2Pin_2.0x1.2mm

Connections:
+3V3: C303.1, C304.1, C305.1, J3.4, J102.10, J302.8, J304.2, J701.4 (VDD), R302.1, R303.1, R304.1, R305.1, R308.1, R309.1, R310.1, R701.2, R702.1, U301.C1 (VCC), U302.2 (VDD), U303.2 (VCC)
+5V: J102.11, J302.7
+12V: J102.12, J302.6
/MPU/Charge_Enable: J102.3, U302.18 (IO10)
/MPU/ENABLE_5V: J102.1, U302.20 (IO12)
/MPU/ENABLE_12V: J102.2, U302.19 (IO11)
/MPU/GPIO_Reserve_B2B: J302.4, U302.6 (IO6)
/MPU/I2C_BUS_CLK: J302.2, R303.2, U302.5 (IO5)
/MPU/I2C_BUS_SDA: J302.1, R302.2, U302.4 (IO4)
/MPU/I2C_SMBus_SCL: J3.2, J102.14, R308.2, U302.22 (IO14), U303.8 (SCL)
/MPU/I2C_SMBus_SDA: J3.3, J102.13, R309.2, U302.23 (IO21), U303.7 (SDA)
/MPU/Interface_RST: J302.3, U302.7 (IO7)
/MPU/LED_ROT: R306.1, U302.35 (IO42)
/MPU/RST: R304.2, U301.A1 (/RESET), U302.3 (EN)
/MPU/RTC_INTERRUPT: R310.2, U302.21 (IO13), U303.3 (~INT/SQW)
/MPU/SD_CARD_DETECT: J701.9 (DET_B), R702.2, U302.12 (IO8)
/MPU/SD_V_SPI_CLK: J701.5 (CLK), U302.38 (IO2)
/MPU/SD_V_SPI_CS: J701.2 (DAT3/CD), U302.11 (IO18)
/MPU/SD_V_SPI_MISO: J701.7 (DAT0), R701.1, U302.31 (IO38)
/MPU/SD_V_SPI_MOSI: J701.3 (CMD), U302.39 (IO1)
/MPU/UART_RXD0: J304.1, U302.36 (RXD0)
/MPU/UART_TXD0: J304.3, U302.37 (TXD0)
/MPU/~PG: J102.4, U302.14 (IO20)
/MPU/~STAT1: J102.6, U302.17 (IO9)
/MPU/~STAT2: J102.5, U302.13 (IO19)
GND: C301.2, C302.2, C303.2, C304.2, C305.2, J1.2, J2.4, J3.1, J102.7, J102.8, J301.2, J302.5, J304.4, J701.6 (VSS), J701.10 (DET_A), J701.11 (SHIELD), J701.12 (SHIELD), J701.13 (SHIELD), R301.2, SW301.2, TP303.1, U301.C2 (GND), U302.1 (GND), U302.40 (GND), U302.EPAD (GND), U303.5 (GND), U303.6 (VBAT)
unnamed: J2.1, R2.1
unnamed: J2.2, R306.2
unnamed: J2.3, R1.1
unnamed: J301.1, U301.B2 (/MR)
unnamed: R301.1, U301.B1 (SEL)
unnamed: R305.2, U301.A2 (/SRESET), U302.10 (IO17)
unnamed: SW301.1, U302.27 (IO0)
unnamed: C301.1, U302.8 (IO15), Y301.2
unnamed: C302.1, U302.9 (IO16), Y301.1
