HyFiVeUser/HyFiVe/01_Logger/02_Modular_Logger/01_Electronics/01_Main_Unit/01_main_unit_MCI/main_unit.kicad_pcb

## KiCad design 01_Logger/02_Modular_Logger/01_Electronics/01_Main_Unit/01_main_unit_MCI/main_unit.kicad_pcb (2025-11-26)

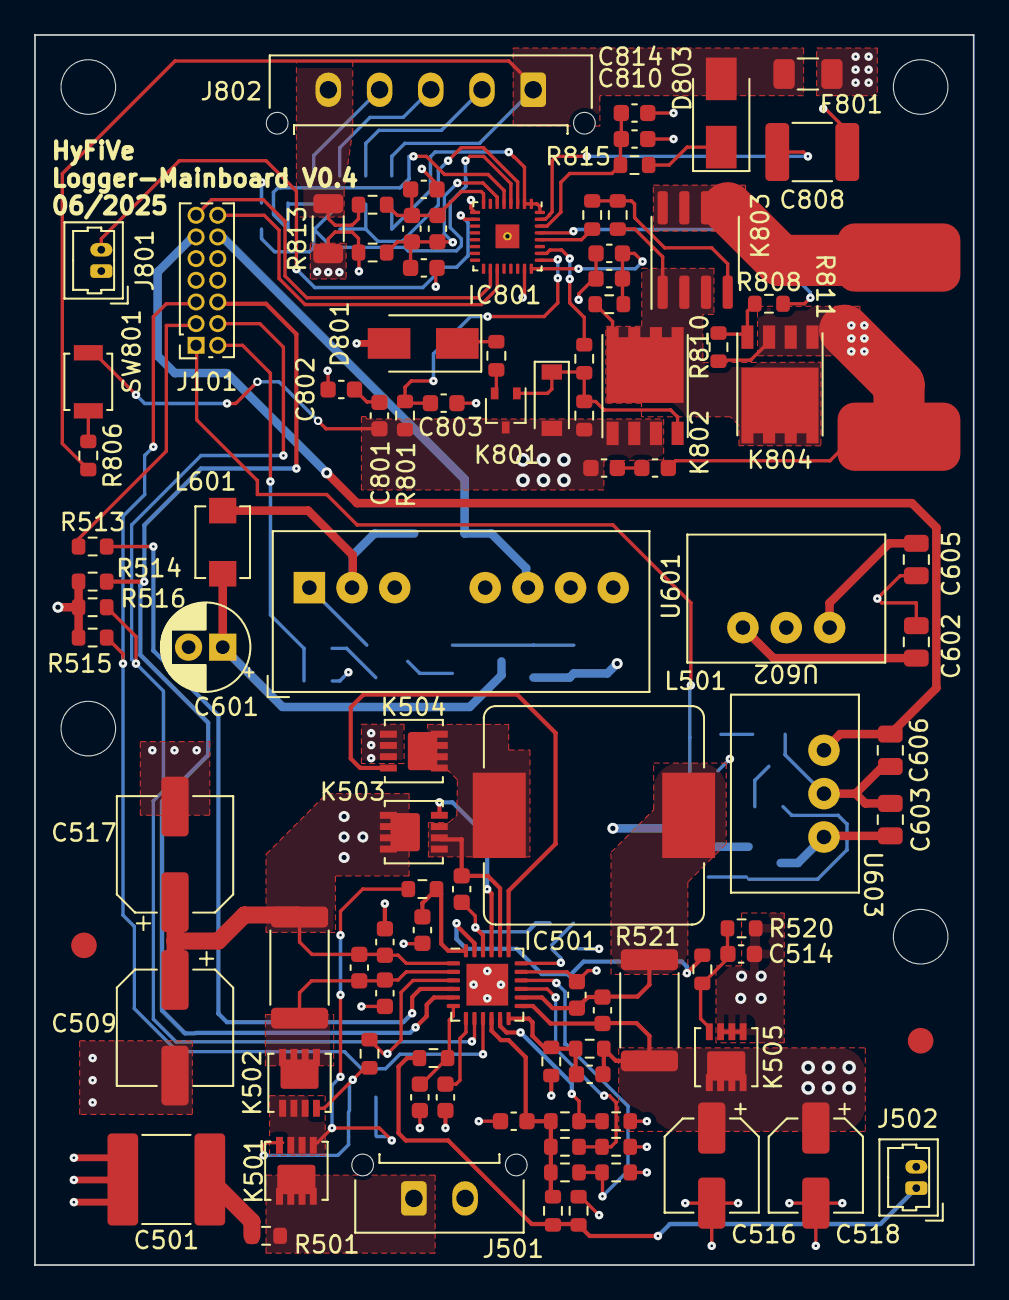
[picture p34: board 01_Logger/02_Modular_Logger/01_Electronics/01_Main_Unit/01_main_unit_… from above]

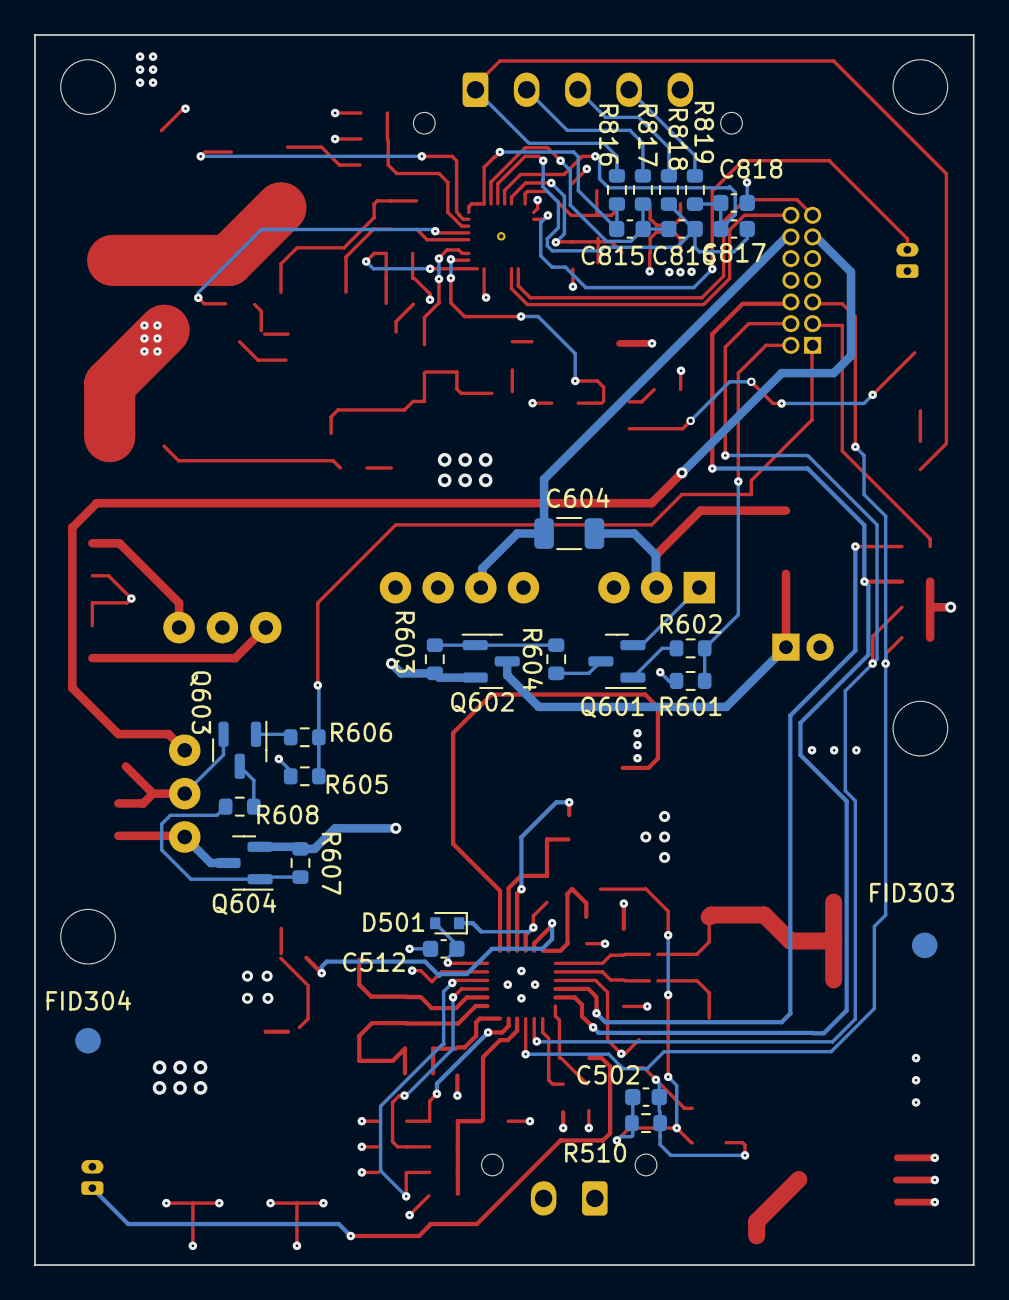
[picture p35: board 01_Logger/02_Modular_Logger/01_Electronics/01_Main_Unit/01_main_unit_… from below]

Board: 4 copper layers, 55.0 x 72.1 mm, 132 parts (27 on the bottom side), 78 nets.

Parts:
C501: 47µF 35V X7R; C_2220_5650Metric
C502, C503, C505, C506, C507, C511, C513, C514, C515, C801, C802, C806, C807, C809, C812, C813, C815, C816, C817, C818: 100nF 50V; C_0603_1608Metric
C504: 1µF 10V; C_0603_1608Metric
C508: 33nF 25V; C_0603_1608Metric
C509, C517: 47µF 35V; CP_Elec_6.3x5.4
C510, C512: 1µF 35V; C_0603_1608Metric
C516, C518: 20µF 35V; CP_Elec_5x5.3
C519: 22pF 35V; C_0603_1608Metric
C601: 10µF, 50V; CP_Radial_D5.0mm_P2.00mm
C602, C603: 22µF 30V; C_0805_2012Metric
C604: 150pF, 2kV; C_1206_3216Metric
C605, C606: 47µF 10V; C_0805_2012Metric
C803: 10nF, 50V; C_0603_1608Metric
C804, C805, C810, C814: 100pF 50V; C_0603_1608Metric
C808: 2,2µF 100V; C_1812_4532Metric
C811: 100pF 100V; C_0603_1608Metric
D501: BAT54W; D_SOD-523
D801, D803: SS1H10-E3/61T; D_SMA
D802: MMSZ5246B-7-F; D_SOD-123
F801: 12A; Fuse_1206_3216Metric
FID301, FID302, FID303, FID304: Fiducial; Passmarke
H301, H302, H304, H306: MountingHole; MountingHole_3.2mm_M3_ISO7380
IC501: BQ24618; VQFN-24-1EP_4x4mm_P0.5mm_EP2.45x2.45mm
IC801: BQ40Z80; RSM32 VQFN-32-1EP_4x4mm_P0.4mm_EP1.4x1.4mm_ThermalVias
J101: SFMC-107-01-L-D; PinSocket_2x07_P1.27mm_Vertical
J501: Conn_01x02; Molex_Micro-Fit_3.0_43650-0215_1x02_P3.00mm_Vertical
J502: Conn_01x02_Female; Molex_PicoBlade_53047-0210_1x02_P1.25mm_Vertical
J801: Conn_01x02_Male; Molex_PicoBlade_53047-0210_1x02_P1.25mm_Vertical
J802: Conn_01x05_Male; Molex_Micro-Fit_3.0_43650-0515_1x05_P3.00mm_Vertical
K501, K502, K505: SISH101DN-T1-GE3; PowerPAK 1212-8 Single
K503, K504: SiS412DN; PowerPAK 1212-8 Single
K801: 2N7002KW; SOT-323_SC-70
K802, K804: CSD18540Q5B; TI Q5B-Package
K803: DMP6023LSS-13; SOIC-8_3.9x4.9mm_P1.27mm
L501: 3,3µH; L_Bourns_SRP1245A
L601: 10µH; CC453232A
Q601, Q603: BSS123; SOT-23
Q602, Q604: IRLML5203TRPBF; SOT-23
R501, R511, R812, R814, R815: 100R; R_0603_1608Metric
R502, R507, R802, R809: 10k; R_0603_1608Metric
R503: 5.7k; R_0603_1608Metric
R504: R_Therm_1; R_0603_1608Metric
R505: R_Therm_2; R_0603_1608Metric
R506, R510, R520: 100k; R_0603_1608Metric
R508: 232k; R_0603_1608Metric
R509: 33k; R_0603_1608Metric
R512, R519, R604, R608, R808: 1k; R_0603_1608Metric
R513: 0R; R_0603_1608Metric
R514, R515, R516, R523: 49,9k; R_0603_1608Metric
R517, R521: 10m; R_2512_6332Metric
R518: 10R; R_0603_1608Metric
R522: 357k; R_0603_1608Metric
R601, R605: 2k7; R_0603_1608Metric
R602, R606: 47k; R_0603_1608Metric
R603, R607: 680k; R_0603_1608Metric
R801: 1,1k; R_0603_1608Metric
R803, R807, R810: 10M; R_0603_1608Metric
R804: 4,81k; R_0603_1608Metric
R805: 510R; R_0603_1608Metric
R806: 51R; R_0603_1608Metric
R811: 46.4 5W; R_4527_11570Metric
R813: 1m; R_1206_3216Metric
R816, R817, R818, R819: 499R; R_0603_1608Metric
SW801: SW_Push; SW_SPST_B3U-1000P
U601: SPBW06F-12; Converter_DCDC_XP_POWER-ITxxxxxS_THT
U602: OKI-78SR-3.3_1.5-W36-C; DC_DC_Converter
U603: OKI-78SR-5_1.5-W36-C; DC_DC_Converter

Connections:
+3V3: C605.1, J101.10, R514.1, R515.1, R516.1, U602.3 (OUT)
+5V: C606.1, J101.11, U603.3 (OUT)
+12V: C604.2, J101.12, U601.6 (+VOUT)
/power/BMS/BAT_MINUS: J802.5, R813.2, R814.1
/power/BMS/BAT_PLUS: D803.2 (A), F801.2, J802.1, R806.2, R816.1
/power/BMS/BAT_PLUS_F: C807.1, F801.1, K804.1, K804.2, K804.3, R810.2, R811.2
/power/BMS/PACK+: C515.1, C516.1, C518.1, C519.2, C801.1, C806.1, D802.2 (A), IC501.13 (SRN), K505.5, K505.6, K505.7, K505.8, K505.9, K801.3, K802.1, K802.2, K802.3, R521.1, R522.1, R801.2, R803.2, SW801.2
/power/Battery_Charger/ACP: C503.2, C505.1, IC501.2 (ACP), K502.5, K502.6, K502.7, K502.8, K502.9, R517.2
/power/Battery_Charger/Thermistor: J502.1, R504.1, R505.2, R511.1
/power/Battery_Charger/VIN: J501.1, K501.5, K501.6, K501.7, K501.8, K501.9, R501.1
/power/Battery_Charger/VREF: C504.1, IC501.10 (VREF), R502.1, R504.2, R506.1, R508.1
/power/Charge_Enable: J101.3, R513.1
/power/ENABLE_5V: J101.1, R605.2, R606.1
/power/ENABLE_12V: J101.2, R601.2, R602.1
/power/I2C_SMBus_SCL: IC801.19 (SMBC), J101.14
/power/I2C_SMBus_SDA: IC801.18 (SMBD), J101.13
/power/System+: C505.2, C507.2, C509.1, C514.1, C517.1, C602.1, IC501.1 (ACN), K503.5, K503.6, K503.7, K503.8, K503.9, K505.1, K505.2 (S), K505.3 (S), Q602.2 (S), Q604.2 (S), R517.1, R520.1, R603.2, R607.2, U602.1 (IN)
/power/~PG: IC501.8 (~PG), J101.4, R516.2
/power/~STAT1: IC501.5 (~STAT1), J101.6, R514.2
/power/~STAT2: IC501.9 (~STAT2), J101.5, R515.2
GND: C501.2, C503.1, C504.2, C506.1, C507.1, C508.1, C509.2, C510.2, C512.2, C513.1, C516.2, C517.2, C518.2, C601.2, C602.2, C603.2, C605.2, C606.2, C802.2, C803.2, C804.1, C805.1, C808.2, C809.1, C810.1, C813.1, C814.1, C818.2, D801.2 (A), IC501.17 (GND), IC501.25 (PwrPad), IC801.9 (VSS), IC801.23 (FUSE), IC801.33 (PAD), J101.7, J101.8, J501.2, J502.2, J801.1, K504.1, K504.2 (S), K504.3 (S), Q601.2 (S), Q603.2 (S), R503.2, R505.1, R507.2, R509.2, R523.2, R601.1, R605.1, R812.2, R813.1, U601.1 (-VIN), U601.7 (-VOUT), U602.2 (GND), U603.2 (GND)
unnamed: C501.1, R501.2
unnamed: C502.1, K501.1, K501.2 (S), K501.3 (S), K502.1, K502.2 (S), K502.3 (S), R510.1, R518.2
unnamed: C502.2, K501.4, K502.4, R510.2, R512.1
unnamed: C514.2, K505.4, R519.1, R520.2
unnamed: C801.2, C802.1
unnamed: C806.2, C807.2
unnamed: C512.1, D501.2 (A), IC501.18 (REGN)
unnamed: C511.1, D501.1 (K), IC501.22 (BTST)
unnamed: D801.1 (K), R802.1
unnamed: D802.1 (K), K801.1, K802.4, R803.1, R804.2
unnamed: D803.1 (K), R815.1
unnamed: IC501.16 (ACSET), R502.2, R503.1
unnamed: IC501.4 (CE), R513.2
unnamed: IC501.21 (HIDRV), K503.4
unnamed: IC501.11 (ISET1), R508.2, R509.1
unnamed: IC501.15 (ISET2), R506.2, R507.1
unnamed: IC501.19 (LODRV), K504.4
unnamed: C511.2, IC501.20 (PH), K503.1, K503.2 (S), K503.3 (S), K504.5, K504.6, K504.7, K504.8, K504.9, L501.1
unnamed: C513.2, C515.2, IC501.14 (SRP), L501.2, R521.2
unnamed: C506.2, IC501.6 (TS), R511.2
unnamed: C508.2, IC501.7 (TTC)
unnamed: C510.1, IC501.24 (VCC), R518.1
unnamed: C519.1, IC501.12 (VFB), R522.2, R523.1
unnamed: IC501.3 (~ACDRV), R512.2
unnamed: IC501.23 (~BATDRV), R519.2
unnamed: C810.2, C814.2, IC801.30 (BAT), R815.2
unnamed: IC801.29 (CHG), R808.1
unnamed: IC801.26 (DSG), R804.1
unnamed: C808.1, IC801.31 (PBI)
unnamed: IC801.28 (PCHG), R809.1
unnamed: C803.1, IC801.25 (Pack), R801.1
unnamed: C809.2, C811.2, C812.2, IC801.6 (SRN), R812.1
unnamed: C811.1, C812.1, C813.2, IC801.8 (SRP), R814.2
unnamed: IC801.10 (TS1), J801.2
unnamed: C817.2, C818.1, IC801.5 (VC1), R819.2
unnamed: C816.2, C817.1, IC801.4 (VC2), R818.2
unnamed: C815.2, C816.1, IC801.3 (VC3), R817.2
unnamed: C815.1, IC801.1 (VC5), IC801.2 (VC4), IC801.32 (VC6), R816.2
unnamed: C804.2, C805.2, IC801.24 (VCC), R805.1
unnamed: J802.2, R817.1
unnamed: J802.3, R818.1
unnamed: J802.4, R819.1
unnamed: K801.2, R802.2
unnamed: K802.5, K802.6, K802.7, K802.8, K802.9, K803.1, K803.2, K803.3, K804.5, K804.6, K804.7, K804.8, K804.9, R805.2, R807.2
unnamed: K803.4, R807.1, R809.2
unnamed: K803.5, K803.6, K803.7, K803.8, R811.1
unnamed: K804.4, R808.2, R810.1
unnamed: Q601.3 (D), R604.1
unnamed: Q601.1 (G), R602.2
unnamed: C601.1, L601.1, Q602.3 (D)
unnamed: Q602.1 (G), R603.1, R604.2
unnamed: Q603.3 (D), R608.1
unnamed: Q603.1 (G), R606.2
unnamed: C603.1, Q604.3 (D), U603.1 (IN)
unnamed: Q604.1 (G), R607.1, R608.2
unnamed: R806.1, SW801.1
unnamed: C604.1, L601.2, U601.2 (+VIN)
