HyFiVeUser/HyFiVe/01_Logger/02_Modular_Logger/01_Electronics/02_Adapter/Analog-Adapter/Analog-Adapter.kicad_pcb

## KiCad design 01_Logger/02_Modular_Logger/01_Electronics/02_Adapter/Analog-Adapter/Analog-Adapter.kicad_pcb (2025-11-10)

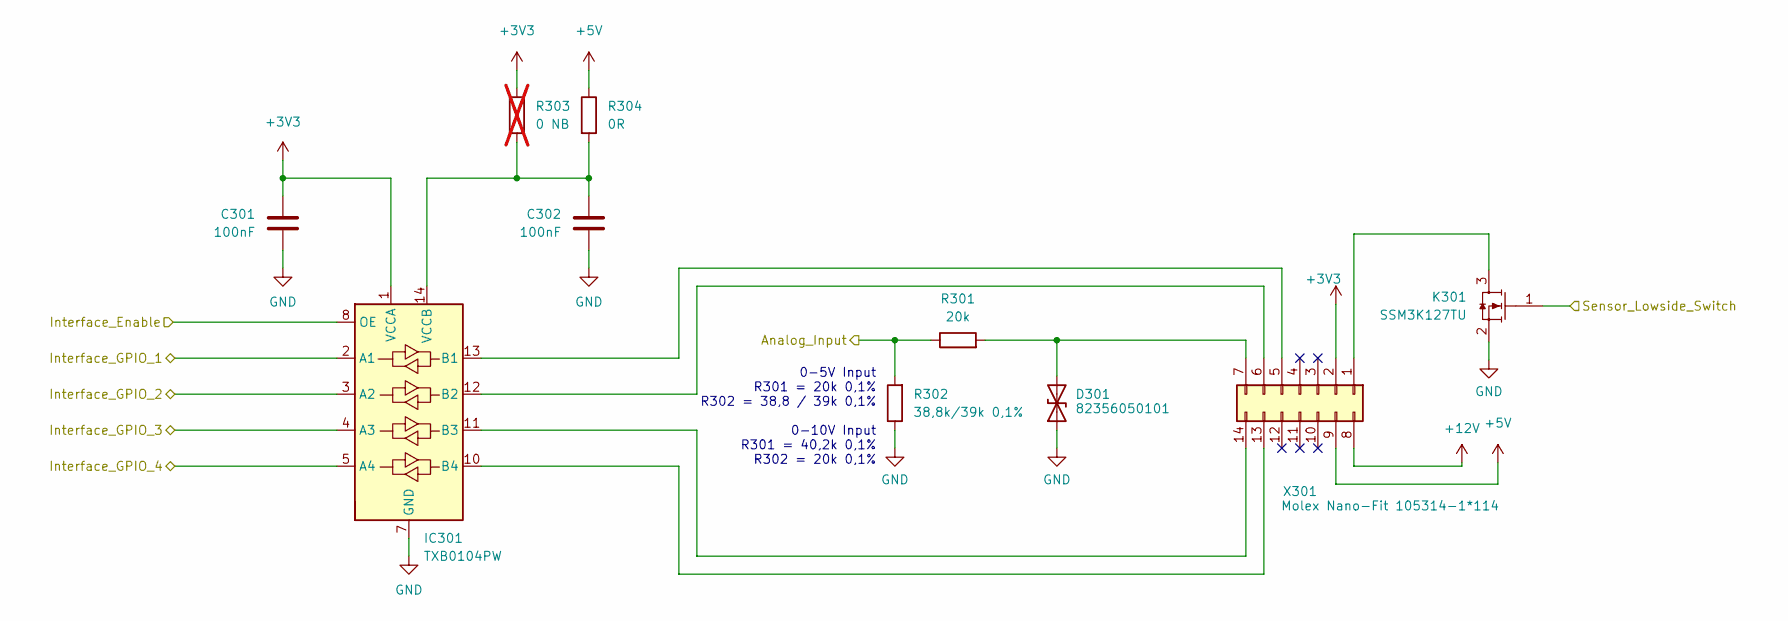
[picture p36: schematic Interface_Analog.kicad_sch]

Parts:
C301, C302: 100nF; C_0603_1608Metric_Pad1.08x0.95mm_HandSolder
D301: 82356050101; D_0603_1608Metric
IC301: TXB0104PW; TSSOP-14_4.4x5mm_P0.65mm
K301: SSM3K127TU; SOT-23
R301: 20k; R_0603_1608Metric_Pad0.98x0.95mm_HandSolder
R302: 38,8k/39k 0,1%; R_0603_1608Metric_Pad0.98x0.95mm_HandSolder
R303: 0 NB; R_0603_1608Metric_Pad0.98x0.95mm_HandSolder; not fitted
R304: 0R; R_0603_1608Metric_Pad0.98x0.95mm_HandSolder
X301: Molex Nano-Fit 105314-1*114; Molex_Nano-Fit_105314-xx14_2x07_P2.50mm_Horizontal

Connections:
+3V3: C301.1, IC301.1 (VCCA), R303.1, X301.2; also elsewhere on the board
+5V: R304.1, X301.9; also elsewhere on the board
+12V: X301.8; also elsewhere on the board
/MCU/Interface_Analog: R301.1, R302.2; also elsewhere on the board
/MCU/Interface_Enable: IC301.8 (OE); also elsewhere on the board
/MCU/Interface_GPIO_1: IC301.2 (A1); also elsewhere on the board
/MCU/Interface_GPIO_2: IC301.3 (A2); also elsewhere on the board
/MCU/Interface_GPIO_3: IC301.4 (A3); also elsewhere on the board
/MCU/Interface_GPIO_4: IC301.5 (A4); also elsewhere on the board
/MCU/Sensor_Lowside_Switch: K301.1; also elsewhere on the board
GND: C301.2, C302.2, D301.1 (A1), IC301.7 (GND), K301.2, R302.1; also elsewhere on the board
unnamed: D301.2 (A2), R301.2, X301.7
unnamed: IC301.13 (B1), X301.5
unnamed: IC301.12 (B2), X301.6
unnamed: IC301.11 (B3), X301.14
unnamed: IC301.10 (B4), X301.13
unnamed: C302.1, IC301.14 (VCCB), R303.2, R304.2
unnamed: K301.3, X301.1

Notes on the sheet:
0-5V Input R301 = 20k 0,1% R302 = 38,8 / 39k 0,1% 0-10V Input R301 = 40,2k 0,1% R302 = 20k 0,1%

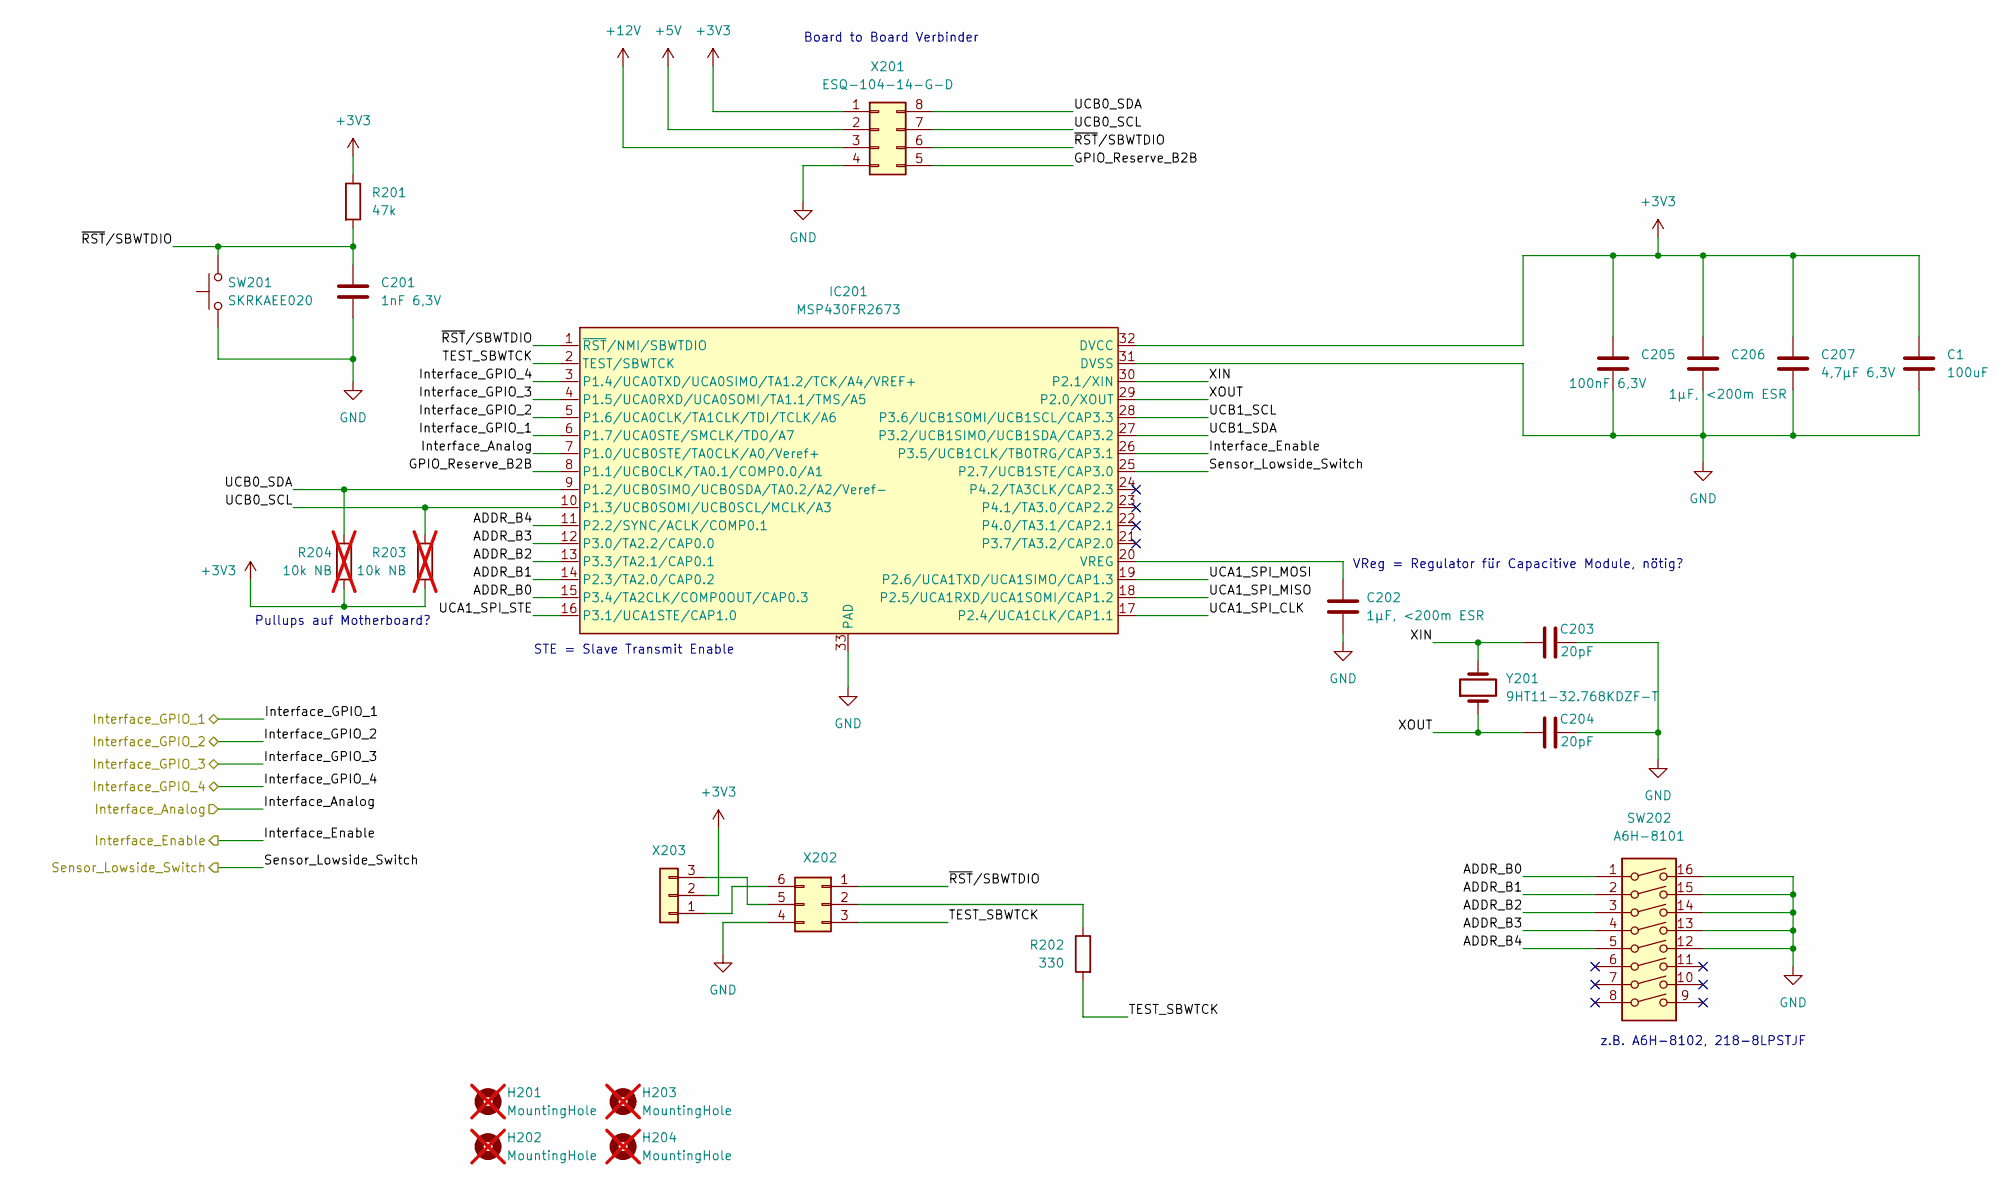
[picture p37: schematic MCU.kicad_sch]

Parts:
C1: 100uF; C_0805_2012Metric_Pad1.18x1.45mm_HandSolder
C201: 1nF 6,3V; C_0603_1608Metric_Pad1.08x0.95mm_HandSolder
C202, C206: 1µF, <200m ESR; C_0603_1608Metric_Pad1.08x0.95mm_HandSolder
C203, C204: 20pF; C_0603_1608Metric_Pad1.08x0.95mm_HandSolder
C205: 100nF 6,3V; C_0603_1608Metric_Pad1.08x0.95mm_HandSolder
C207: 4,7µF 6,3V; C_0603_1608Metric_Pad1.08x0.95mm_HandSolder
H201, H202, H203, H204: MountingHole; MountingHole_2.7mm_M2.5; not fitted
IC201: MSP430FR2673; VQFN-32-1EP_5x5mm_P0.5mm_EP3.5x3.5mm
R201: 47k; R_0603_1608Metric_Pad0.98x0.95mm_HandSolder
R202: 330; R_0603_1608Metric_Pad0.98x0.95mm_HandSolder
R203, R204: 10k NB; R_0603_1608Metric_Pad0.98x0.95mm_HandSolder; not fitted
SW201: SKRKAEE020; SW_Push_SPST_NO_Alps_SKRK
SW202: A6H-8101; SW_DIP_SPSTx08_Slide_Omron_A6H-8101_W6.15mm_P1.27mm
X201: ESQ-104-14-G-D; PinSocket_2x04_P2.54mm_Vertical
X202: Conn_02x03_Counter_Clockwise; PinHeader_2x03_P2.54mm_Vertical
X203: Conn_01x03; PinHeader_1x03_P2.54mm_Vertical
Y201: 9HT11-32.768KDZF-T; Crystal_SMD_TXC_9HT11-2Pin_2.0x1.2mm_HandSoldering

Connections:
+3V3: C1.1, C205.1, C206.1, C207.1, IC201.32 (DVCC), R201.1, R203.2, R204.2, X201.1, X203.2; also elsewhere on the board
+5V: X201.2; also elsewhere on the board
+12V: X201.3; also elsewhere on the board
/MCU/ADDR_B0: IC201.15 (P3.4/TA2CLK/COMP0OUT/CAP0.3), SW202.1
/MCU/ADDR_B1: IC201.14 (P2.3/TA2.0/CAP0.2), SW202.2
/MCU/ADDR_B2: IC201.13 (P3.3/TA2.1/CAP0.1), SW202.3
/MCU/ADDR_B3: IC201.12 (P3.0/TA2.2/CAP0.0), SW202.4
/MCU/ADDR_B4: IC201.11 (P2.2/SYNC/ACLK/COMP0.1), SW202.5
/MCU/GPIO_Reserve_B2B: IC201.8 (P1.1/UCB0CLK/TA0.1/COMP0.0/A1), X201.5
/MCU/Interface_Analog: IC201.7 (P1.0/UCB0STE/TA0CLK/A0/Veref+); also elsewhere on the board
/MCU/Interface_Enable: IC201.26 (P3.5/UCB1CLK/TB0TRG/CAP3.1); also elsewhere on the board
/MCU/Interface_GPIO_1: IC201.6 (P1.7/UCA0STE/SMCLK/TDO/A7); also elsewhere on the board
/MCU/Interface_GPIO_2: IC201.5 (P1.6/UCA0CLK/TA1CLK/TDI/TCLK/A6); also elsewhere on the board
/MCU/Interface_GPIO_3: IC201.4 (P1.5/UCA0RXD/UCA0SOMI/TA1.1/TMS/A5); also elsewhere on the board
/MCU/Interface_GPIO_4: IC201.3 (P1.4/UCA0TXD/UCA0SIMO/TA1.2/TCK/A4/VREF+); also elsewhere on the board
/MCU/Sensor_Lowside_Switch: IC201.25 (P2.7/UCB1STE/CAP3.0); also elsewhere on the board
/MCU/TEST_SBWTCK: IC201.2 (TEST/SBWTCK), R202.2, X202.3
/MCU/UCA1_SPI_CLK: IC201.17 (P2.4/UCA1CLK/CAP1.1)
/MCU/UCA1_SPI_MISO: IC201.18 (P2.5/UCA1RXD/UCA1SOMI/CAP1.2)
/MCU/UCA1_SPI_MOSI: IC201.19 (P2.6/UCA1TXD/UCA1SIMO/CAP1.3)
/MCU/UCA1_SPI_STE: IC201.16 (P3.1/UCA1STE/CAP1.0)
/MCU/UCB0_SCL: IC201.10 (P1.3/UCB0SOMI/UCB0SCL/MCLK/A3), R203.1, X201.7
/MCU/UCB0_SDA: IC201.9 (P1.2/UCB0SIMO/UCB0SDA/TA0.2/A2/Veref-), R204.1, X201.8
/MCU/UCB1_SCL: IC201.28 (P3.6/UCB1SOMI/UCB1SCL/CAP3.3)
/MCU/UCB1_SDA: IC201.27 (P3.2/UCB1SIMO/UCB1SDA/CAP3.2)
/MCU/XIN: C203.1, IC201.30 (P2.1/XIN), Y201.2
/MCU/XOUT: C204.1, IC201.29 (P2.0/XOUT), Y201.1
/MCU/~RST/SBWTDIO: C201.1, IC201.1 (~RST/NMI/SBWTDIO), R201.2, SW201.2, X201.6, X202.1
GND: C1.2, C201.2, C202.2, C203.2, C204.2, C205.2, C206.2, C207.2, IC201.31 (DVSS), IC201.33 (PAD), SW201.1, SW202.12, SW202.13, SW202.14, SW202.15, SW202.16, X201.4, X202.4; also elsewhere on the board
unnamed: C202.1, IC201.20 (VREG)
unnamed: R202.1, X202.2
unnamed: X202.5, X203.3
unnamed: X202.6, X203.1

Notes on the sheet:
STE = Slave Transmit Enable
Pullups auf Motherboard?
Board to Board Verbinder
z.B. A6H-8102, 218-8LPSTJF
VReg = Regulator für Capacitive Module, nötig?

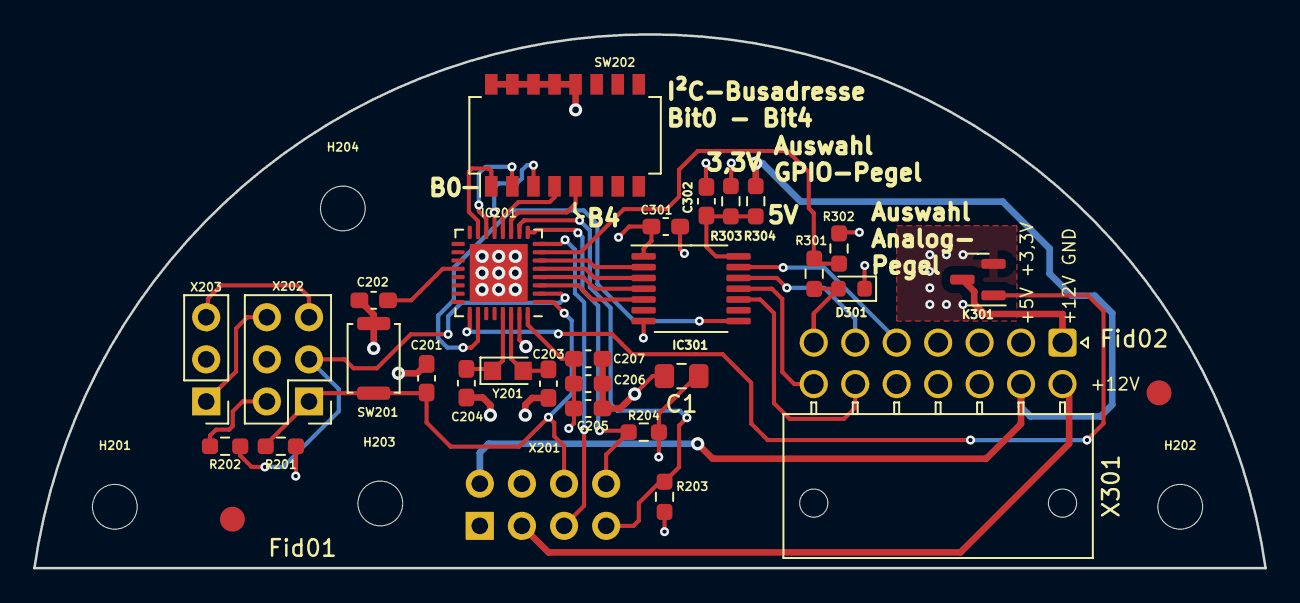
[picture p38: board Analog-Adapter.kicad_pcb from above]

Board: 4 copper layers, 74.2 x 32.2 mm, 35 parts (1 on the bottom side), 34 nets.

Other parts of the board:
Fid01, Fid02: Fiducial_1.5mm_Mask4.5mm
