HyFiVeUser/HyFiVe/01_Logger/02_Modular_Logger/03_Software/Logger-Mainboard-Beta/src/LedManager.cpp

/*
 * CopyrightText: (C) 2024 Hensel Elektronik GmbH
 *
 * License-Identifier: MPL-2.0
 *
 * Project: Hydrography on Fishing Vessels
 * Project URL: <https://github.com/HyFiVeUser/HyFiVe>, <https://hyfive.info>
 *
 * Description: LED control and status indication
 */

#include "DeepSleep.h"
#include "LedManager.h"
#include "NVSPreferences.h"
#include "SensorManagement.h"
#include "SystemVariables.h"
#include "Utility.h"

int greenPin = -1;
int bluePin  = -1;
int redPin   = 42;

// Bei Common-Anode auf true setzen (Pegel werden invertiert)
const bool COMMON_ANODE = false;
inline int ON() { return COMMON_ANODE ? LOW : HIGH; }
inline int OFF() { return COMMON_ANODE ? HIGH : LOW; }

enum class LedHw
{
  RGB,
  RED_ONLY
};
static LedHw ledHw = LedHw::RED_ONLY;

// ------------------------------------------------------------
//  Low-Level: Setzen der LED-Farben
// ------------------------------------------------------------

static volatile bool s_magnetOverlayActive = false;
static bool s_baseR                        = false;
static bool s_baseG                        = false;
static bool s_baseB                        = false;

static void writeRGBHardware(bool r, bool g, bool b)
{
  if (ledHw == LedHw::RED_ONLY)
  {
    bool anyOn = r || g || b;
    digitalWrite(redPin, anyOn ? ON() : OFF());
    return;
  }

  digitalWrite(redPin, r ? ON() : OFF());
  digitalWrite(greenPin, g ? ON() : OFF());
  digitalWrite(bluePin, b ? ON() : OFF());
}

static void setRGB(bool r, bool g, bool b)
{
  // Basiszustand immer aktualisieren. Während des Magnet-Overlays
  // läuft das eigentliche LED-Signal dadurch intern zeitlich weiter.
  s_baseR = r;
  s_baseG = g;
  s_baseB = b;

  if (s_magnetOverlayActive)
    return;

  writeRGBHardware(r, g, b);
}

// Magnet verwendet dieselbe Farbe wie normalUsage(), schreibt aber direkt
// auf die Hardware und verändert den Basiszustand des laufenden Signals nicht.
static void writeMagnetOverlayOn()
{
  uint8_t colorCode = (ledColorConfig / 100) % 10;

  switch (colorCode)
  {
  case 1:
    writeRGBHardware(true, false, false);
    break;
  case 2:
    writeRGBHardware(false, true, false);
    break;
  case 3:
    writeRGBHardware(true, true, false);
    break;
  case 4:
    writeRGBHardware(false, false, true);
    break;
  case 5:
    writeRGBHardware(true, false, true);
    break;
  case 6:
    writeRGBHardware(false, true, true);
    break;
  case 7:
    writeRGBHardware(true, true, true);
    break;
  default:
    writeRGBHardware(false, true, false); // Fallback wie normalUsage()
    break;
  }
}

static void allOff() { setRGB(false, false, false); }
static void red() { setRGB(true, false, false); }
static void green() { setRGB(false, true, false); }
static void blue() { setRGB(false, false, true); }
static void yellow() { setRGB(true, true, false); }
static void magenta() { setRGB(true, false, true); }
static void cyan() { setRGB(false, true, true); }
static void white() { setRGB(true, true, true); }

static void applyColorFromCode(uint8_t colorCode, void (*fallback)())
{
  switch (colorCode)
  {
  case 1:
    red();
    break;
  case 2:
    green();
    break;
  case 3:
    yellow();
    break;
  case 4:
    blue();
    break;
  case 5:
    magenta();
    break;
  case 6:
    cyan();
    break;
  case 7:
    white();
    break;
  default:
    fallback();
    break;
  }
}

String printBits(uint32_t value)
{
  String result = "";

  for (int i = 18; i >= 0; i--)
  {
    result += String((value >> i) & 1);
  }

  return result;
}

void resetLedBitMask() { ledBitMask = 0; }

void normalUsage()
{
  uint8_t normalColorCode = (ledColorConfig / 100) % 10;
  applyColorFromCode(normalColorCode, green);
}
void interaction()
{
  uint8_t interactionColorCode = (ledColorConfig / 10) % 10;
  applyColorFromCode(interactionColorCode, yellow);
}
void errors()
{
  uint8_t errorColorCode = ledColorConfig % 10;
  applyColorFromCode(errorColorCode, red);
}

// ------------------------------------------------------------
//  Hardware-Variante initialisieren
// ------------------------------------------------------------

static void hwVariante()
{
  if (readPrefs() == "000001") // if ((readPrefs() == "000001") && (rgbVersion == 1))
  {
    greenPin = 37;
    bluePin  = 36;
    redPin   = 42;
    ledHw    = LedHw::RGB;
  }
  else
  {
    greenPin = -1;
    bluePin  = -1;
    redPin   = 42;
    ledHw    = LedHw::RED_ONLY;
  }
}

static void ledPMode()
{
  if (redPin >= 0)
    pinMode(redPin, OUTPUT);
  if (greenPin >= 0)
    pinMode(greenPin, OUTPUT);
  if (bluePin >= 0)
    pinMode(bluePin, OUTPUT);

  allOff();
}

// ------------------------------------------------------------
//  Timings
// ------------------------------------------------------------

static const uint32_t ledSignalLoggerDetectsBeginOfDeployment = 30000; // ms
static const uint32_t ledSignalShort                          = 200;   // ms
static const uint32_t ledSignalLong                           = 600;   // ms
static const uint32_t ledSignalBreakBetweenLetters            = 200;   // ms
static const uint32_t ledSignalPermanent                      = 2000;  // ms
static const uint32_t ledSignalPauseBetweenSignals            = 3000;  // ms
static const uint32_t ledSignalPauseBetweenSignalsEvent1to5   = 800;   // ms

// ------------------------------------------------------------
//  Interne Task-Steuerung
// ------------------------------------------------------------

static TaskHandle_t s_ledTaskHandle           = nullptr;
static TaskHandle_t s_magnetOverlayTaskHandle = nullptr;
static QueueHandle_t s_ledQueue               = nullptr;
static bool s_ledTaskSuspendedForError        = false;

// Hilfsfunktion: Wartezeit, aber abbrechbar durch neuen Mode
static bool waitOrNewMode(uint32_t ms, LedMode &newModeOut)
{
  if (!s_ledQueue)
  {
    vTaskDelay(pdMS_TO_TICKS(ms));
    return false;
  }

  if (xQueueReceive(s_ledQueue, &newModeOut, pdMS_TO_TICKS(ms)) == pdTRUE)
    return true;

  return false;
}

// Separater Overlay-Task:
// - magnetDetected verdrängt keinen LedMode aus s_ledQueue
// - der laufende LedMode setzt seinen Basiszustand weiter
// - sichtbar ist während des Overlays ausschließlich das Magnet-Signal
static void magnetOverlayTask(void *pvParameters)
{
  while (true)
  {
    // Warten, bis ledControl(LedMode::magnetDetected) das Overlay startet.
    ulTaskNotifyTake(pdTRUE, portMAX_DELAY);

    while (true)
    {
      Serial.println("magnetDetected (overlay)");
      s_magnetOverlayActive = true;

      // Bestehendes Magnet-Signal: kurz EIN ...
      writeMagnetOverlayOn();

      // Ein erneutes Magnet-Event startet das Overlay von vorne.
      if (ulTaskNotifyTake(pdTRUE, pdMS_TO_TICKS(ledSignalShort)) > 0)
        continue;

      // ... danach die bisherige Event-Pause. Auch diese Pause überblendet
      // das Hintergrundsignal, die LED bleibt hier also bewusst aus.
      writeRGBHardware(false, false, false);

      if (ulTaskNotifyTake(pdTRUE, pdMS_TO_TICKS(ledSignalPauseBetweenSignalsEvent1to5)) > 0)
        continue;

      // Overlay beendet: den Zustand sichtbar machen, den der im Hintergrund
      // weitergelaufene LED-Modus inzwischen erreicht hat.
      s_magnetOverlayActive = false;
      setRGB(s_baseR, s_baseG, s_baseB);
      break;
    }
  }
}

extern uint8_t REED_INPUT_PIN;

static void fatalErrorDelay(uint32_t ms)
{
  const uint32_t stepMs     = 20;
  static bool magnetLatched = false;

  for (uint32_t elapsed = 0; elapsed < ms; elapsed += stepMs)
  {
    const bool magnetNow = (digitalRead(REED_INPUT_PIN) == LOW);

    // Nur auf die LOW-Flanke reagieren. So startet ein dauerhaft angelegter
    // Magnet das Overlay nicht alle 20 ms erneut.
    if (magnetNow && !magnetLatched)
    {
      Serial.println("Event: 1	Magnet detected");
      ledBitMask |= 0b1000000000000000000;

      // Nur überblenden; fatalError() und sein Muster laufen weiter.
      ledControl(LedMode::magnetDetected);
    }

    magnetLatched = magnetNow;
    delay(min(stepMs, ms - elapsed));
  }
}

// ------------------------------------------------------------
//  Pattern-Runner: gibt den nächsten Mode zurück
//  - entweder Off (wenn fertig)
//  - oder einen neuen Mode, wenn währenddessen umgeschaltet wurde
// ------------------------------------------------------------

static LedMode runMode(LedMode mode)
{
  LedMode incoming = LedMode::Off;

  switch (mode)
  {
  // -----------------------
  // Boot/Status one-shot
  // -----------------------
  case LedMode::loggerBusyBackgroundProcess:
  {
    Serial.println("loggerBusyBackgroundProcess");

    while (1)
    {
      interaction();
      if (waitOrNewMode(ledSignalLong, incoming))
        return incoming;
      allOff();
      if (waitOrNewMode(ledSignalBreakBetweenLetters, incoming))
        return incoming;
      interaction();
      if (waitOrNewMode(ledSignalShort, incoming))
        return incoming;
      allOff();
      if (waitOrNewMode(ledSignalPauseBetweenSignals, incoming))
        return incoming;

      if (!statusIsLoggerBusy.load())
      {
        break;
      }
    }

    statusLED = true;

    allOff();
    return LedMode::Off;
  }

  case LedMode::magnetDetected:
  {
    Serial.println("magnetDetected");
    normalUsage();
    if (waitOrNewMode(ledSignalShort, incoming))
      return incoming;
    allOff();
    if (waitOrNewMode(ledSignalPauseBetweenSignalsEvent1to5, incoming))
      return incoming;

    allOff();
    return LedMode::Off;
  }

  case LedMode::loggerActive:
  {
    Serial.println("loggerActive");
    normalUsage();
    if (waitOrNewMode(ledSignalShort, incoming))
      return incoming;
    allOff();
    if (waitOrNewMode(ledSignalPauseBetweenSignalsEvent1to5, incoming))
      return incoming;

    allOff();
    return LedMode::Off;
  }

  case LedMode::chargingComplete:
  {
    Serial.println("chargingComplete");
    normalUsage();
    if (waitOrNewMode(ledSignalPermanent, incoming))
      return incoming;
    allOff();
    if (waitOrNewMode(ledSignalPauseBetweenSignals, incoming))
      return incoming;

    statusLED = true;

    allOff();
    return LedMode::Off;
  }

  case LedMode::batteryCharging:
  {
    Serial.println("batteryCharging");
    interaction();
    delay(ledSignalShort);
    allOff();
    delay(ledSignalPauseBetweenSignals);

    allOff();
    return LedMode::Off;
  }

  case LedMode::batteryLow:
  {
    Serial.println("batteryLow");
    errors();
    delay(ledSignalShort);
    allOff();
    delay(ledSignalBreakBetweenLetters);

    errors();
    delay(ledSignalShort);
    allOff();
    delay(ledSignalPauseBetweenSignals);

    statusLED = true;

    allOff();
    return LedMode::Off;
  }

  case LedMode::batterySuperlow:
  {
    Serial.println("batterySuperlow");
    errors();
    delay(ledSignalLong);
    allOff();
    delay(ledSignalBreakBetweenLetters);

    errors();
    delay(ledSignalLong);
    allOff();
    delay(ledSignalPauseBetweenSignals);

    statusLED = true;

    allOff();
    return LedMode::Off;
  }

  case LedMode::ntpUpdateFailed:
  {
    Serial.println("ntpUpdateFailed");

    for (int i = 0; i < 3; i++)
    {
      errors();
      delay(ledSignalShort);
      allOff();
      delay(ledSignalBreakBetweenLetters);

      errors();
      delay(ledSignalShort);
      allOff();
      delay(ledSignalBreakBetweenLetters);

      errors();
      delay(ledSignalShort);
      allOff();
      delay(ledSignalPauseBetweenSignals);
    }

    statusLED = true;

    allOff();
    return LedMode::Off;
  }

  case LedMode::configRejected:
  {
    Serial.println("configRejected");

    for (int i = 0; i < 3; i++)
    {
      errors();
      delay(ledSignalLong);
      allOff();
      delay(ledSignalBreakBetweenLetters);

      errors();
      delay(ledSignalLong);
      allOff();
      delay(ledSignalBreakBetweenLetters);

      errors();
      delay(ledSignalLong);
      allOff();
      delay(ledSignalPauseBetweenSignals);
    }

    statusLED = true;

    allOff();
    return LedMode::Off;
  }

  case LedMode::noConnectionToDeckbox:
  {
    Serial.println("noConnectionToDeckbox");

    errors();
    delay(ledSignalShort);
    allOff();
    delay(ledSignalBreakBetweenLetters);

    errors();
    delay(ledSignalLong);
    allOff();
    delay(ledSignalBreakBetweenLetters);

    errors();
    delay(ledSignalShort);
    allOff();
    delay(ledSignalPauseBetweenSignals);

    statusLED = true;

    allOff();
    return LedMode::Off;
  }

  case LedMode::skipSensorError:
  {
    Serial.println("skipSensorError");

    errors();
    delay(ledSignalShort);
    allOff();
    delay(ledSignalBreakBetweenLetters);

    errors();
    delay(ledSignalShort);
    allOff();
    delay(ledSignalBreakBetweenLetters);

    errors();
    delay(ledSignalLong);
    allOff();
    delay(ledSignalBreakBetweenLetters);

    errors();
    delay(ledSignalLong);
    allOff();
    delay(ledSignalPauseBetweenSignals);

    statusLED = true;

    allOff();
    return LedMode::Off;
  }

  case LedMode::updateBootComplete:
  {
    Serial.println("updateBootComplete");

    interaction();
    delay(ledSignalPermanent);
    allOff();
    delay(ledSignalPauseBetweenSignals);

    statusLED = true;

    allOff();
    return LedMode::Off;
  }

  case LedMode::startConfigUpdate:
  {
    Serial.println("startConfigUpdate");

    interaction();
    delay(ledSignalShort);
    allOff();
    delay(ledSignalBreakBetweenLetters);

    interaction();
    delay(ledSignalShort);
    allOff();
    delay(ledSignalPauseBetweenSignals);

    statusLED = true;

    allOff();
    return LedMode::Off;
  }

  case LedMode::startReboot:
  {
    Serial.println("startReboot");

    interaction();
    delay(ledSignalLong);
    allOff();
    delay(ledSignalBreakBetweenLetters);

    interaction();
    delay(ledSignalLong);
    allOff();
    delay(ledSignalPauseBetweenSignals);

    statusLED = true;

    allOff();
    return LedMode::Off;
  }

  case LedMode::transmissionComplete:
  {
    Serial.println("transmissionComplete");

    normalUsage();
    if (waitOrNewMode(ledSignalPermanent, incoming))
      return incoming;
    allOff();
    if (waitOrNewMode(ledSignalPauseBetweenSignals, incoming))
      return incoming;

    statusLED = true;

    allOff();
    return LedMode::Off;
  }

  // -----------------------
  // Sensor-spezifisch
  // -----------------------
  case LedMode::loggerDetectsBeginOfDeployment:
  {
    sensorStartDone                   = false;
    const uint32_t blinkDurationMs    = ledSignalLoggerDetectsBeginOfDeployment;
    const uint32_t firstOnDurationMs  = ledSignalShort;
    const uint32_t firstOffDurationMs = ledSignalBreakBetweenLetters;

    TickType_t start = xTaskGetTickCount();
    TickType_t end   = start + pdMS_TO_TICKS(blinkDurationMs);

    while (xTaskGetTickCount() < end)
    {
      if (!skipSensor)
      {
        normalUsage();
        if (waitOrNewMode(firstOnDurationMs, incoming))
        {
          allOff();
          sensorStartDone = true;
          return incoming;
        }
      }
      else
      {
        {
          errors();

          Serial.println("Event: 16	skip sensor error");
          ledBitMask |= 0b0000000000000001000;

          if (waitOrNewMode(firstOnDurationMs, incoming))
          {
            allOff();
            sensorStartDone = true;
            return incoming;
          }
        }
      }

      allOff();
      if (waitOrNewMode(firstOffDurationMs, incoming))
      {
        sensorStartDone = true;
        return incoming;
      }
    }

    allOff();
    sensorStartDone = true;
    return LedMode::Off;
  }

  case LedMode::duringDeployment:
    ledMeasurementsOff.store(false);

    if (!skipSensor)
    {
      normalUsage();
      if (waitOrNewMode(ledSignalShort, incoming))
        return incoming;
      allOff();
      if (waitOrNewMode(ledSignalBreakBetweenLetters, incoming))
        return incoming;
    }
    else
    {
      errors();

      Serial.println("Event: 16	skip sensor error");
      ledBitMask |= 0b0000000000000001000;

      if (waitOrNewMode(ledSignalShort, incoming))
        return incoming;
      allOff();
      if (waitOrNewMode(ledSignalBreakBetweenLetters, incoming))
        return incoming;
    }

    ledMeasurementsOff.store(true);

    return LedMode::Off;

  case LedMode::loggerDetectsEndOfDeployment:
  {
    ledMeasurementsOff.store(false);

    normalUsage();
    if (waitOrNewMode(ledSignalLong, incoming))
      return incoming;
    allOff();
    if (waitOrNewMode(ledSignalBreakBetweenLetters, incoming))
      return incoming;
    normalUsage();
    if (waitOrNewMode(ledSignalLong, incoming))
      return incoming;
    allOff();
    if (waitOrNewMode(ledSignalBreakBetweenLetters, incoming))
      return incoming;

    ledMeasurementsOff.store(true);

    return LedMode::Off;
  }

  // -----------------------
  default:
    allOff();
    return LedMode::Off;
  }
}

// ------------------------------------------------------------
//  Der eine LED-Task
// ------------------------------------------------------------

static void ledTask(void *pvParameters)
{
  LedMode mode = LedMode::Off;

  while (true)
  {
    if (mode == LedMode::Off)
    {
      allOff();
      // Warte auf neuen Mode
      xQueueReceive(s_ledQueue, &mode, portMAX_DELAY);
      continue;
    }

    // Mode ausführen (one-shot oder blockierend)
    mode = runMode(mode);
  }
}

// ------------------------------------------------------------
//  Init + Public Control
// ------------------------------------------------------------

void ledInit()
{
  hwVariante();
  ledPMode();

  if (!s_ledQueue)
  {
    // Länge 1 reicht: wir wollen immer nur den neuesten Mode
    s_ledQueue = xQueueCreate(1, sizeof(LedMode));
  }

  if (!s_ledTaskHandle)
  {
    xTaskCreatePinnedToCore(ledTask, "LedServiceTask", 4096, nullptr, 1, &s_ledTaskHandle, 1);
  }

  if (!s_magnetOverlayTaskHandle)
  {
    // Höhere Priorität als der normale LED-Task, damit das Overlay sofort
    // sichtbar wird, ohne den laufenden Modus anzuhalten.
    xTaskCreatePinnedToCore(magnetOverlayTask, "LedMagnetOverlay", 2048, nullptr, 2, &s_magnetOverlayTaskHandle, 1);
  }

  // Startzustand
  LedMode off = LedMode::Off;
  xQueueOverwrite(s_ledQueue, &off);
}

/**
 * DER eine öffentliche Einstieg:
 * - Übergib den gewünschten Modus
 * - LedMode::Off stoppt alles sofort
 */
void ledControl(LedMode mode)
{
  // magnetDetected ist ein Overlay und darf den aktuell laufenden Modus
  // nicht aus der Queue verdrängen.
  if (mode == LedMode::magnetDetected)
  {
    if (s_magnetOverlayTaskHandle)
      xTaskNotifyGive(s_magnetOverlayTaskHandle);
    return;
  }

  if (!s_ledQueue)
    return;

  xQueueOverwrite(s_ledQueue, &mode);
}

void fatalError()
{
  if (s_ledTaskHandle && !s_ledTaskSuspendedForError)
  {
    vTaskSuspend(s_ledTaskHandle);
    s_ledTaskSuspendedForError = true;
  }

  for (int y = 0; y < 10; y++)
  {
    for (int i = 0; i < 3; i++)
    {
      errors();
      fatalErrorDelay(ledSignalShort);
      allOff();
      fatalErrorDelay(ledSignalBreakBetweenLetters);
    }
    for (int i = 0; i < 3; i++)
    {
      errors();
      fatalErrorDelay(ledSignalLong);
      allOff();
      fatalErrorDelay(ledSignalBreakBetweenLetters);
    }
    for (int i = 0; i < 3; i++)
    {
      errors();
      fatalErrorDelay(ledSignalShort);
      allOff();
      fatalErrorDelay(ledSignalBreakBetweenLetters);
    }
  }

  ++generalErrorCounter;

  if (generalErrorCounter >= 3)
  {
    generalErrorCounter = 0;
    interfaceSleep();
    delay(1000);
    enableExternalWakeup(20); // activate Logger if power supply connection
    enableExternalWakeup(17); // activate Logger if reed connection
    statusDeepSleep = true;
    Serial.println("Deep Sleep fatalError");

    Serial.println("Event: 17 fatal error");
    ledBitMask |= 0b0000000000000000100;

    esp_sleep_disable_wakeup_source(ESP_SLEEP_WAKEUP_TIMER);
    esp_deep_sleep_start();
  }

  ESP.restart();
}

/**
 * @brief Sets the reset ESP pin to LOW.
 */
void setResetEspLow() { allOff(); }
