HyFiVeUser/HyFiVe/01_Logger/02_Modular_Logger/03_Software/Logger-Mainboard-Beta/src/SDCard.cpp

/*
 * CopyrightText: (C) 2024 Hensel Elektronik GmbH
 *
 * License-Identifier: MPL-2.0
 *
 * Project: Hydrography on Fishing Vessels
 * Project URL: <https://github.com/HyFiVeUser/HyFiVe>, <https://hyfive.info>
 *
 * Description: SD card initialization and management
 */

#include <SD.h>

#include "LedManager.h"
#include "SDCard.h"

SPIClass initSPIclass;

const uint8_t csPin = 18; // Chip Select Pin

void initializeSpi()
{
  uint8_t sckPin  = 2;  // Clock Pin
  uint8_t misoPin = 38; // Master In Slave Out Pin
  uint8_t mosiPin = 1;  // Master Out Slave In Pin
  initSPIclass.begin(sckPin, misoPin, mosiPin, csPin);
}

/**
 * @brief Initializes the SD card.
 * @return bool True if initialization was successful, false otherwise.
 */
bool initializeSdCard()
{

  initializeSpi();
  delay(50);
  if (SD.begin(csPin, initSPIclass, 80000000))
  {
    // Serial.println("SD card initialized successfully.");
    return true;
  }
  else
  {
    Serial.println("SD card initialized fail");
    fatalError();
    return false;
  }
}
