HyFiVeUser/HyFiVe/(commit log)

2025-10-16 Improve README with updated links for hardware details
    Updated links in the README for schematics and CAD files related to hardware components.
    Added GTIN for USB-C-Plug
2025-10-16 Update BOM.xlsx
    Added GTIN and Link for USB-C-Connector
    [BOM.xlsx]
2025-11-04 Update BOM.xlsx
    Korrektur der Position 16 "Gegenmutter" für den Conductivity Sensor
    [BOM.xlsx]
2025-11-10 Increase antenna size
    [logger_mounting_battery_base.step, logger_mounting_battery_base.stl]
2025-11-10 is not required
    [End_cap_drilling_charging.f3d, End_cap_drilling_charging.step, penetrator_LED.f3d, penetrator_LED.step, penetrator_charging.f3d, penetrator_charging.step]
2025-11-10 re-sorted but no adjustments
    [End_cap_drilling_charging.f3d, End_cap_drilling_charging.step, Logger_cylinder.f3d, Logger_cylinder.step, end_cap_drillings_sensors.f3d, end_cap_drillings_sensors.step, penetrator_sensor_Atlas_K1_0.f3d, penetrator_sensor_Atlas_K1_0.step]
2025-11-10 Add slot for better grip when tightening screws
    [penetrator_charging_V02.step]
2025-11-10 name adjusted to V02
    [logger_mounting_battery_base_V02.step]
2025-11-10 end_cap_drillings_sensors updated
    [end_cap_drillings_sensors.step, end_cap_drillings_sensors_P5_V01_HER.step, end_cap_drillings_sensors_P6_V01_HER.step]
2025-11-10 name adjusted
    [end_cap_drillings_sensors_P5_V01.step, end_cap_drillings_sensors_P6_V01.step]
2025-11-10 main_unit_MCI updated to V0.5
    [Analog-Adapter.kicad_pcb, Analog-Adapter.kicad_sch, Battery_Charger.kicad_sch, HyFiVe-BOM_Adapter.ods, HyFiVe-BOM_Main_Unit.ods, HyFiVe_Main_MCU_V0.5_BOM.csv, I2C-Adapter.kicad_pcb, I2C-Adapter.kicad_sch]
2025-11-10 main_unit_MCU updated to V0.4
    [Battery_Charger.kicad_sch, MPU.kicad_sch, bms.kicad_sch, inductive_power.kicad_sch, main_unit.kicad_pcb, main_unit.kicad_sch, main_unit_MCU.csv, memory.kicad_sch]
2025-11-10 I²C-Interfaceboard V0.3
    [I2C-Adapter.csv, I2C-Adapter.kicad_pcb, I2C-Adapter.kicad_sch, Interface_I2C.kicad_sch, MCU.kicad_sch]
2025-11-10 RS232-Interfaceboard V0.2
    [Interface_RS232.kicad_sch, MCU.kicad_sch, RS232-Adapter.csv, RS232-Adapter.kicad_pcb, RS232-Adapter.kicad_sch]
2025-11-10 RS485-Interfaceboard V0.2
    [Interface_RS485.kicad_sch, MCU.kicad_sch, RS485-Adapter.kicad_pcb, RS485-Adapter.kicad_sch]
2025-11-10 UART-Interfaceboard V0.3
    [Interface_UART.kicad_sch, MCU.kicad_sch, UART-Adapter.csv, UART-Adapter.kicad_pcb, UART-Adapter.kicad_sch]
2025-11-10 Analog-Interfaceboard V0.1
    [Analog-Adapter.kicad_pcb, Analog-Adapter.kicad_sch, Interface_Analog.kicad_sch, MCU.kicad_sch]
2025-11-10 Analog-Interfaceboard V0.2
    [Analog-Adapter.csv, Analog-Adapter.kicad_pcb, Analog-Adapter.kicad_sch, Interface_Analog.kicad_sch, MCU.kicad_sch]
2025-11-11 Analog sensor adapted to 12-bit resolution, Added whether the sensor requires an external parameter
2025-11-14 update to V0.86
    - Multi-client access control: Request to Node-RED to check whether the communication interface is currently busy. Multiple clients can issue requests, but only one is granted exclusive access at a time while others wait.
    - The logger will be able to automatically connect to the Wi-Fi network where the last successful login took place. This removes the need to manually sort the entries in the JSON list in the correct order.
    If the most recently successful Wi-Fi connection cannot be established, the Wi-Fi networks stored in the JSON list are tried one after another. As soon as a connection is successful, it is set as the first choice in the list.
    - When the battery is being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
    [BMS.cpp, BMS.h, Led.cpp, Led.h, MQTTManager.cpp, MQTTManager.h, SystemVariables.h, Utility.cpp]
2025-11-14 Create nodered_all_flows_20251114.json
    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
2025-11-26 Main_Unit Update
    [Battery_Charger.kicad_sch, HyFiVe_Main_MCU_V0.5_BOM.csv, MPU.kicad_sch, bms.kicad_sch, main_unit.csv, main_unit.kicad_pcb, main_unit.kicad_sch, main_unit_MCU.csv]
2025-11-27 Node-RED upadte
    - Node-RED Multi-client access control
    - Firmware update switch (30 min) FW-Gate
2025-12-08 update to V0.86
    update to V0.86
    - When t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
2025-12-10 Update Beta V0.02
    - The LED-Event “Logger detects begin of deployment” has been set to 60 seconds, as specified.
    - Measurement data transmission and log data transmission now have the LED-Event “Logger busy (background process)”.
2025-12-15 Update Beta V0.03
    - DeepSleep has been changed to LightSleep in both the main loop and the sensor measurement loop.
    - Wet sensor (sensor measurement) is now performed once per period.
    - configUpdate and statusUpload now have the LED-Event “Logger busy (background process)”.
2026-01-13 LED.h an .cpp changed to LedManager
2026-01-15 Update Beta V0.05
    - BMS cleaned up
    - generalError monitoring
    - SD card error monitoring added
    - TODO added
    [BMS.cpp, DebuggingSDLog.cpp, LedManager.cpp, SDCard.cpp, SystemVariables.h, Utility.cpp, Utility.h, loggerConfig.cpp]
2026-01-16 Update Beta V0.06
    - fix: configUpdate
    - fix: prio generalError();
    - fix: prio reed connection
    - fix: SD card error monitoring
    [LedManager.cpp, SensorManagement.cpp, SystemVariables.h, Utility.cpp, loggerConfig.cpp, loggerConfig.h, main.cpp]
2026-01-19 Update Beta V0.07
    - Done: Made the log level (logging/debugging) configurable via a config parameter without requiring recompilation.
    - Fix: holdOnReedInputPressed — the logger ID was missing in some MQTT error outputs.
    [DebuggingSDLog.cpp, DebuggingSDLog.h, DebuggingSDSetLog.cpp, DebuggingSDSetLog.h, MQTTManager.cpp, SDCard.cpp, SystemVariables.h, Utility.cpp]
2026-03-02 Update Interfaceboard
    - Pressure sensor (Keller PAA-20D No.: 222022.0129): The interface board basically receives an offset correction in mbar, adjustable via the configuration.
    - O2 (PyroScience PICO-O2-SUB): The interface board output is set to partial pressure (instead of concentration).
    [KellerPressure.cpp, KellerPressure.h, main.c, sensor_config.h]
2026-03-03 Create sensorIntegration.md
    create new md-file for detail description of sensor integration and calibratin
2026-03-03 Update sensorIntegration.md
    first thoughts about usage and calibration process
2026-03-27 Handle for Rope added
    Added CAD-Files for a fixation to handle the logger with a rope.
    The Assembly has all necessary files. Fixation Rings need to be printed or manufactured in a way that doesn't soak water.
    [3d_Print_Cage_Ring_M5_realDim.f3d, 3d_Print_Cage_Ring_M5_realDim.step, 3d_Print_Fixation_Ring_M5_realDim.f3d, 3d_Print_Fixation_Ring_M5_realDim.step, Cage_ring_metal.f3d, Cage_ring_metal.step, Handle_Rope_Assembly.f3z]
2026-03-31 Reduce the waiting time in water from 60 to 30 seconds (Logger detects begin of deployment)
    ledSignalLoggerDetectsBeginOfDeployment = 30000;
2026-04-15 Update loggerConfig.cpp
    ledColorConfig = 241;
2026-06-09 Update pyroPicoO2.cpp
    O2 adapter board: return µmol/l as processed value and partial pressure in mbar as raw value
2026-06-09 O2 adapter board
    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
2026-06-24 Fixed blink-code logic and revised status handling.
    - Added status as a bitmask
    - Adjusted blink pause between signals
    - Fixed incorrect blink codes, as the blink pattern was interrupted by Deep Sleep
    - Added blink code for “Skip Sensor”
    [BMS.cpp, DS3231TimeNtp.cpp, DeepSleep.cpp, LedManager.cpp, LedManager.h, MQTTManager.cpp, SDCard.cpp, SensorManagement.cpp]
2026-07-28 Event 16 includes a dedicated blink code for the skip-sensor erro
    [LedManager.cpp, MQTTManager.cpp, SystemVariables.h, main.cpp]
2026-07-29 Reset MQTT mqttErrorCounter after successful publish
    [MQTTManager.cpp, SystemVariables.h]
2026-07-30 Fix for Event: 16 / 17
    [LedManager.cpp, SystemVariables.h]
2026-08-03 Priority of an LED mode added
2026-08-03 LED mode priority incorrectly reverts to FW:014
    [LedManager.cpp, LedManager.h, SystemVariables.h]
2026-08-03 If the magnetic switch was pressed for less than four seconds, the program got stuck in the while loop.
    [SystemVariables.h, Utility.cpp]
2026-08-10 Update battery status handling and reset MQTT error counter after Wi-Fi retry period
    - Change the battery status from Interaction to Error when the battery level drops below 15%.
    - Reset the mqttErrorCounter after the retry period expires in case of a bad Wi-Fi connection.
2026-08-10 Prioritize magnet blinking // Update battery SOC indication and align blink patterns
    - Prioritize magnet blinking for Fatal Error and Logger BusyFor
    - battery SOC below 15%:
    Set the LED color to red.
    Use blink pattern * *
    - Signal 14 – Battery Superlow (5%): change from - - - to - -.
    - Signal 19 – Config rejected: change from - - to - - -.
2026-08-20 Update sensorIntegration.md
    update conductivity calibration if already a calibration was done
2026-08-20 Update sensorIntegration.md
    clarification
2026-11-09 Add 4S3P battery assembly instructions
