HyFiVeUser/HyFiVe/(notices)

Notices in the files:
01_Logger/02_Modular_Logger/01_Electronics/01_Main_Unit/01_main_unit_MCI/main_unit.kicad_sch:
Todo: Copyright Text
